LArkema/dctransistor-project/board_files/DCTransistor_standard_BOM.xlsx

Comment | Designator | Footprint | LCSC Part Number | Basic? | Doable |  | Old Part Numbers
MMBT3904 | Q1,Q0 | SOT-23 | C20526 | Y | Y |  | C20526
1N5819WS | D1,D0 | SOD-323 | C191023 | Y | Y |  | C191023
SN74LVC1T45DBV | U3 | SOT-23-6 | C7843 | Y | Y |  | C7843
CH340C | U0 | SOIC-16_3.9x9.9mm_P1.27mm | C84681 | N | N |  | C84681
ESP-12F | U2 | ESP-12E | C82891 | N | N |  | C82891
AMS1117-3.3 | U1 | SOT-223-3_TabPin2 | C6186 | Y | Y |  | C351784
SW_SPST | SW0 | SW_DIP_SPSTx01_Slide_6.7x4.1mm_W6.73mm_P2.54mm_LowProfile_JPin | C54948 | N | N |  | C54948
300 | R8 | R_0402_1005Metric | C25102 | Y | Y |  | C138010
12k | R4,R5 | R_0402_1005Metric | C25752 | Y | Y |  | C144798
470 | R1,R2 | R_0402_1005Metric | C25117 | Y | Y | 0402 | C114433
10k | R6,R7,R9 | R_0402_1005Metric | C25744 | Y | Y | 0402 | C17414
5.1kR | R3,R0 | R_0402_1005Metric | C25905 | Y | Y | 0402 | C14677
USB_C_Receptacle | J0 | USB_C_Receptacle_HRO_TYPE-C-31-M-12 | C165948 | N | N |  | C165948
Conn_02x01 | J1 | JST_PH_S2B-PH-SM4-TB_1x02-1MP_P2.00mm_Horizontal | C225233 | N | N |  | C225233
WS2812B | D70,D60,D30,D77,D101,D31,D79,D87,D20,D75,D36,D6,D38,D43,D26,D95,D46,D71,D98,D45,D68,D41,D76,D3,D100,D92,D64,D40,D27,D28,D10,D104,D63,D16,D74,D53,D61,D24,D37,D103,D5,D52,D29,D8,D99,D54,D25,D78,D39,D2,D102,D4,D57,D50,D44,D90,D97,D66,D58,D59,D83,D67,D82,D23,D15,D80,D51,D69,D32,D9,D62,D85,D48,D55,D91,D65,D73,D42,D13,D35,D72,D56,D22,D17,D33,D88,D49,D89,D34,D84,D21,D94,D14,D86,D47,D7,D81,D12,D93,D11,D96,D19,D18,D105,D106 | LED_WS2812B_PLCC4_5.0x5.0mm_P3.2mm-nosilk | C2843785 | N | N | To allow economic assembly | C2761795
100nf | C0,C2 | C_0603_1608Metric | C14663 | Y | Y | 0603 | C88219
10uF | C1,C3,C4,C5,C6,C7,C8,C9,C10,C11,C12,C13,C14,C15,C16,C17,C18,C19,C20,C21,C22,C23,C24,C25,C26,C27,C28,C29,C30,C31,C32,C33,C34,C35,C36,C37,C38,C39,C40,C41,C42 | C_0402_1005Metric | C15525 | Y | Y | 0402 | C466780
