LArkema/dctransistor-project/(threads)

Thread 1 (2022-03-06):

Narrow "Collision Check" for arriving trains

LArkema, 2022-03-06:
Currently, TrainLine's arrived() function  will not update a train's station state if another train is "at" (i.e. has not yet arrived at the next) that station. Designed to stop false-positive arrivals, particularly at 1st station (always waiting, same train may linger). However, a train may legitimately arrive at a station after the train in front has departed, but not yet arrived at next station, causing an incorrect state to propagate.

Fix by checking for specific circuitID of train in front of arriving train.

https://github.com/LArkema/WMATA_PCB/blob/c3f1eccd48eb8d6c2e151f4aa4d2035055f1f0ca/inc/TrainLine.h#L192

LArkema, 2023-04-08:
Closed a long time ago. Kind of forgot that I put this as a GitHub issue.

Closed 2023-04-08.

Thread 2 (2023-05-14):

Order 1090-5438 is missing an On-Off Switch

jasonliu125, 2023-05-14:
I hope you're doing well! My board appears to be missing an on off switch. I see the outline for where it's supposed to be but I cannot turn the board on. Would you be able to send a replacement or exchange this? Image attached.
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

LArkema, 2023-05-14:
Hello,

GitHub issues are meant for bugs and improvements with the software or project files. Individual board problems should be addressed via email to support@dctransistor.com or other DCTransistor email address to resolve individual issues. Please see email correspondence for this order.

Thank you for understanding, but this issue will be deleted in order to keep the repo focused on the open source project.

Closed 2023-05-14.

Thread 5 (2024-08-01):

Changelog?

pmwoodward3, 2024-08-01:
Really love this project! I have what I think is the OG board from the first run and it's still going strong.

I see that most of the releases just state that they are being pushed out from the automated pipeline, but I was wondering if there's any more information that we can get as far as what's being updated.

LArkema, 2024-08-01:
Ah, I had no idea anyone was actually watching the GitHub for update information. For the foreseeable future, the best bet is probably going to be looking at the commit history, as I try to summarize substantive changes when I push them (esp. for minor and major version updates).

PRs to the compile-sketches.yml file that make release notes more substantive (when it's not bumping a dependency or SSL fingerprint) are certainly welcome :)

Thread 6 (2025-06-26):

Not an issue, per se…

sean-bossinger, 2025-06-26:
Just curious for the folks following: has anyone thought through how to get the board to reflect the new service pattern on the Silver Line?

Might be cool to try that as a new fork.

I just didn’t want to go it my own way if someone else had thought about this.

LArkema, 2025-07-03:
Oh darn good catch. I'm swamped this summer and don't want to commit to any specific timelines, but I be able to set aside a day to work on this in September? Of course, if anyone else wants to fork and submit a PR, happy to accept that :)
