LArkema/dctransistor-project/board_files/DCTransistor_Bidirectional.kicad_sch

## KiCad design board_files/DCTransistor_Bidirectional.kicad_sch (2024-09-09)

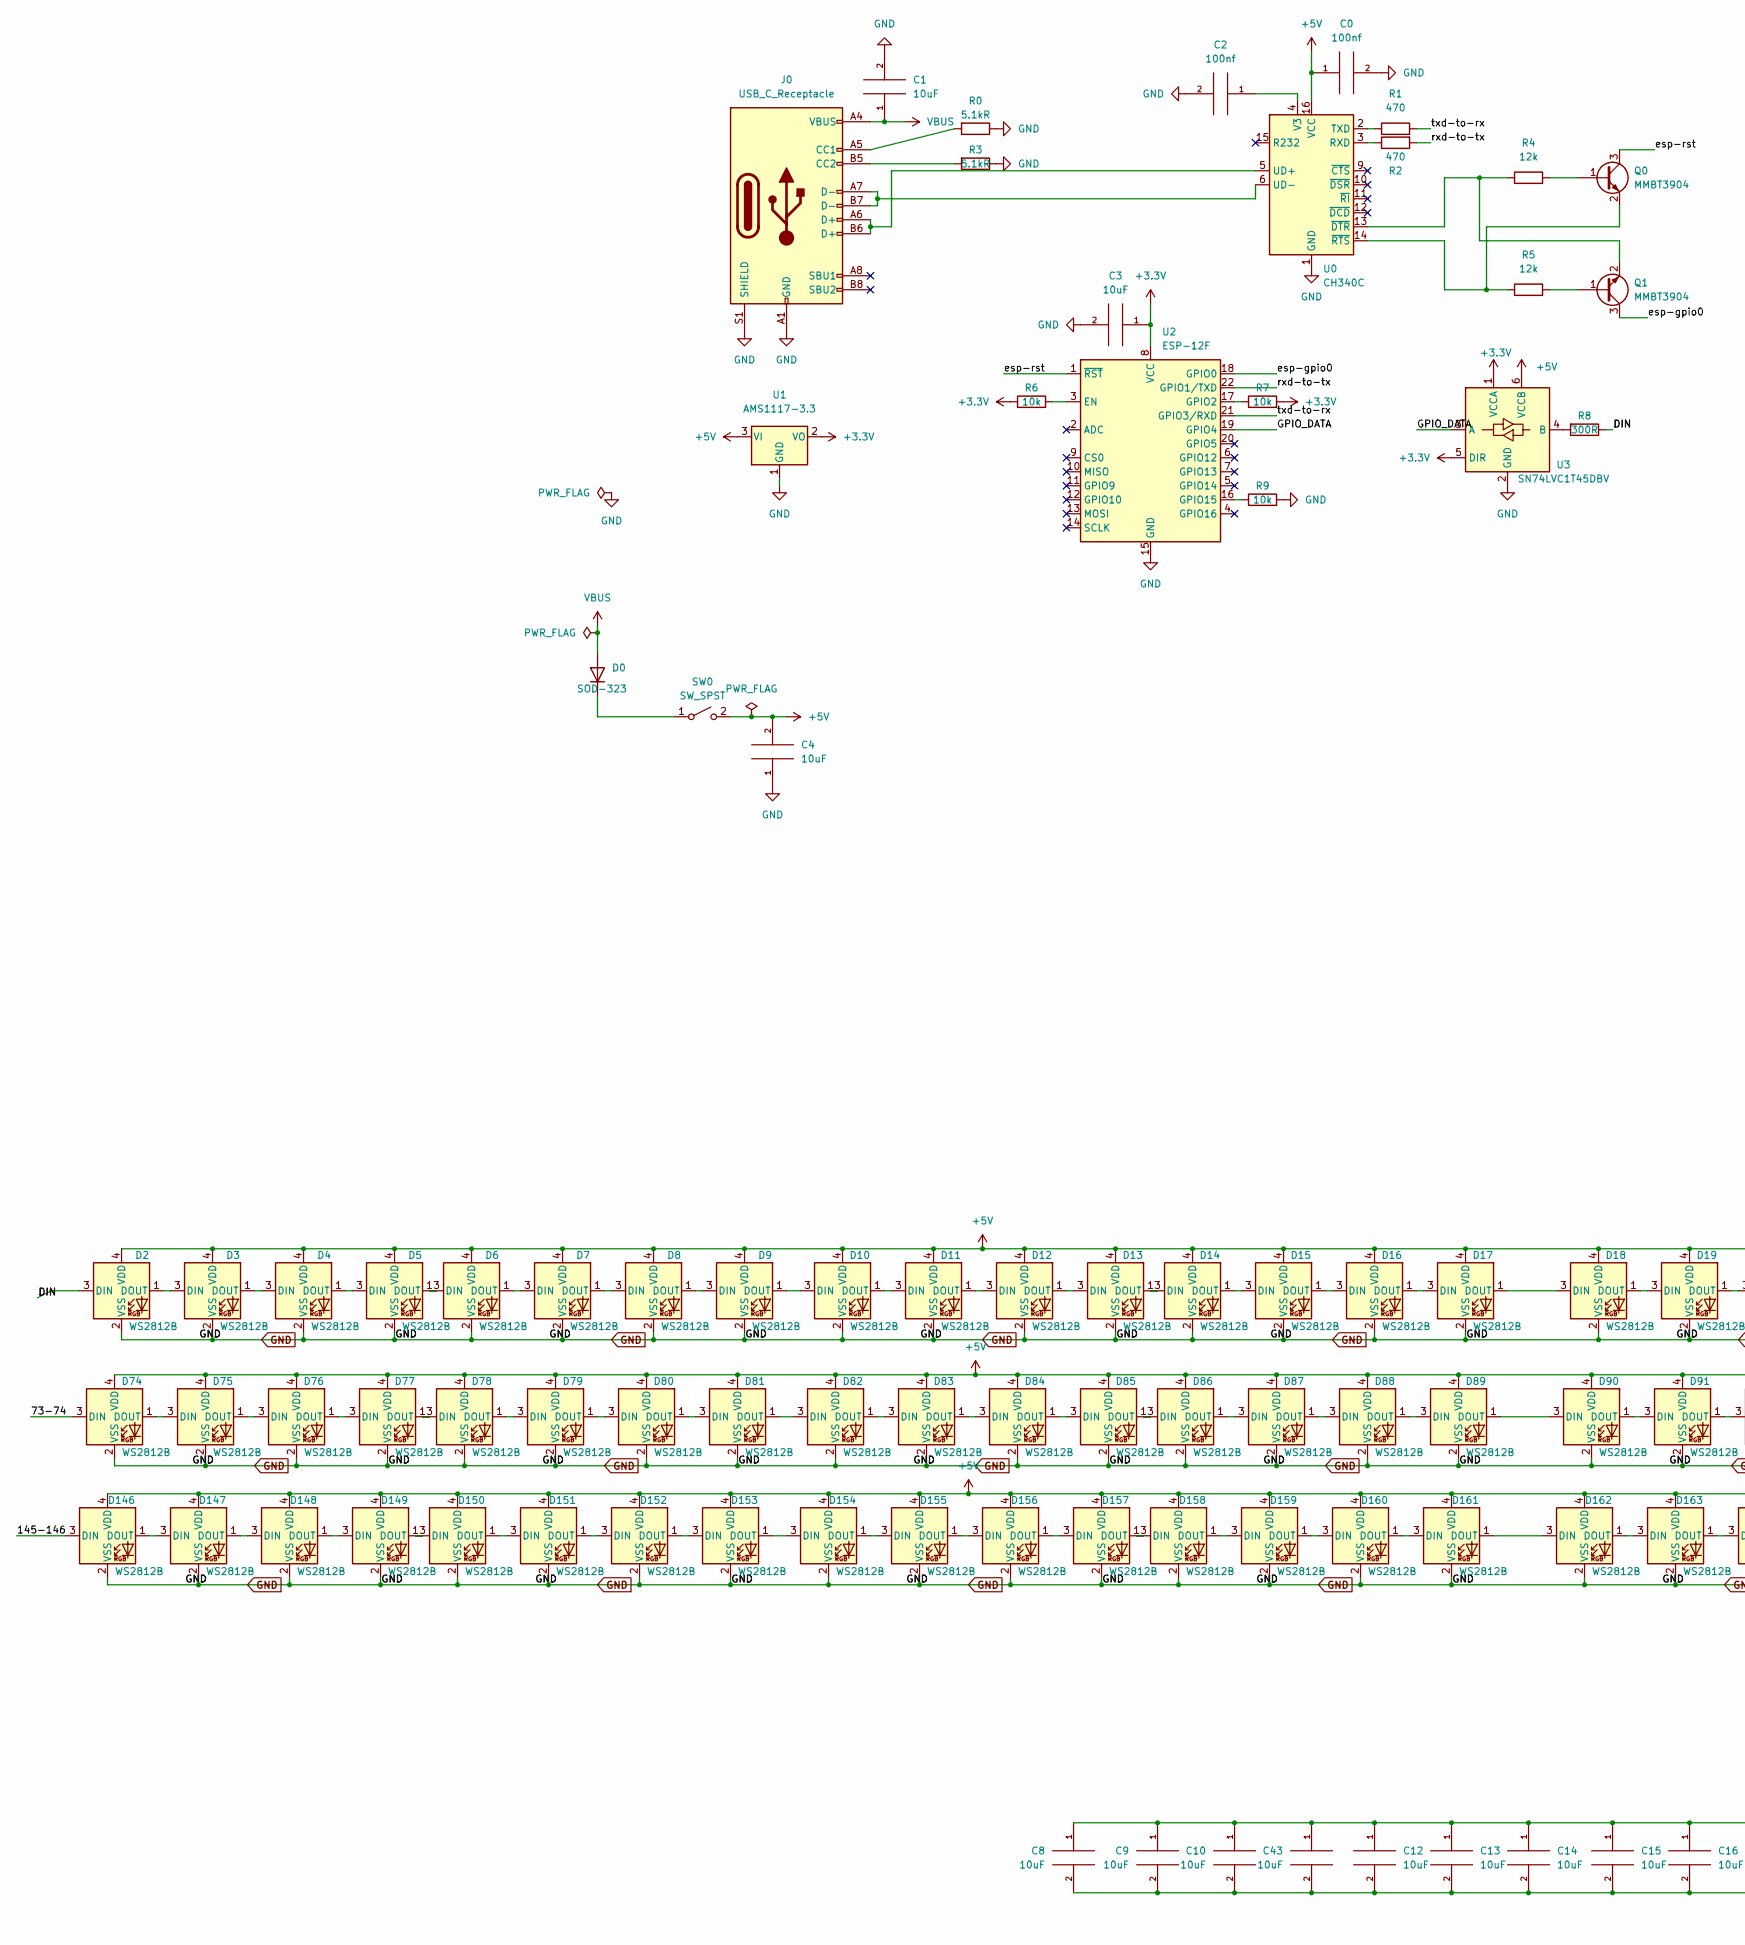
[picture p1: schematic DCTransistor_Bidirectional.kicad_sch, part in row 1, column 1]

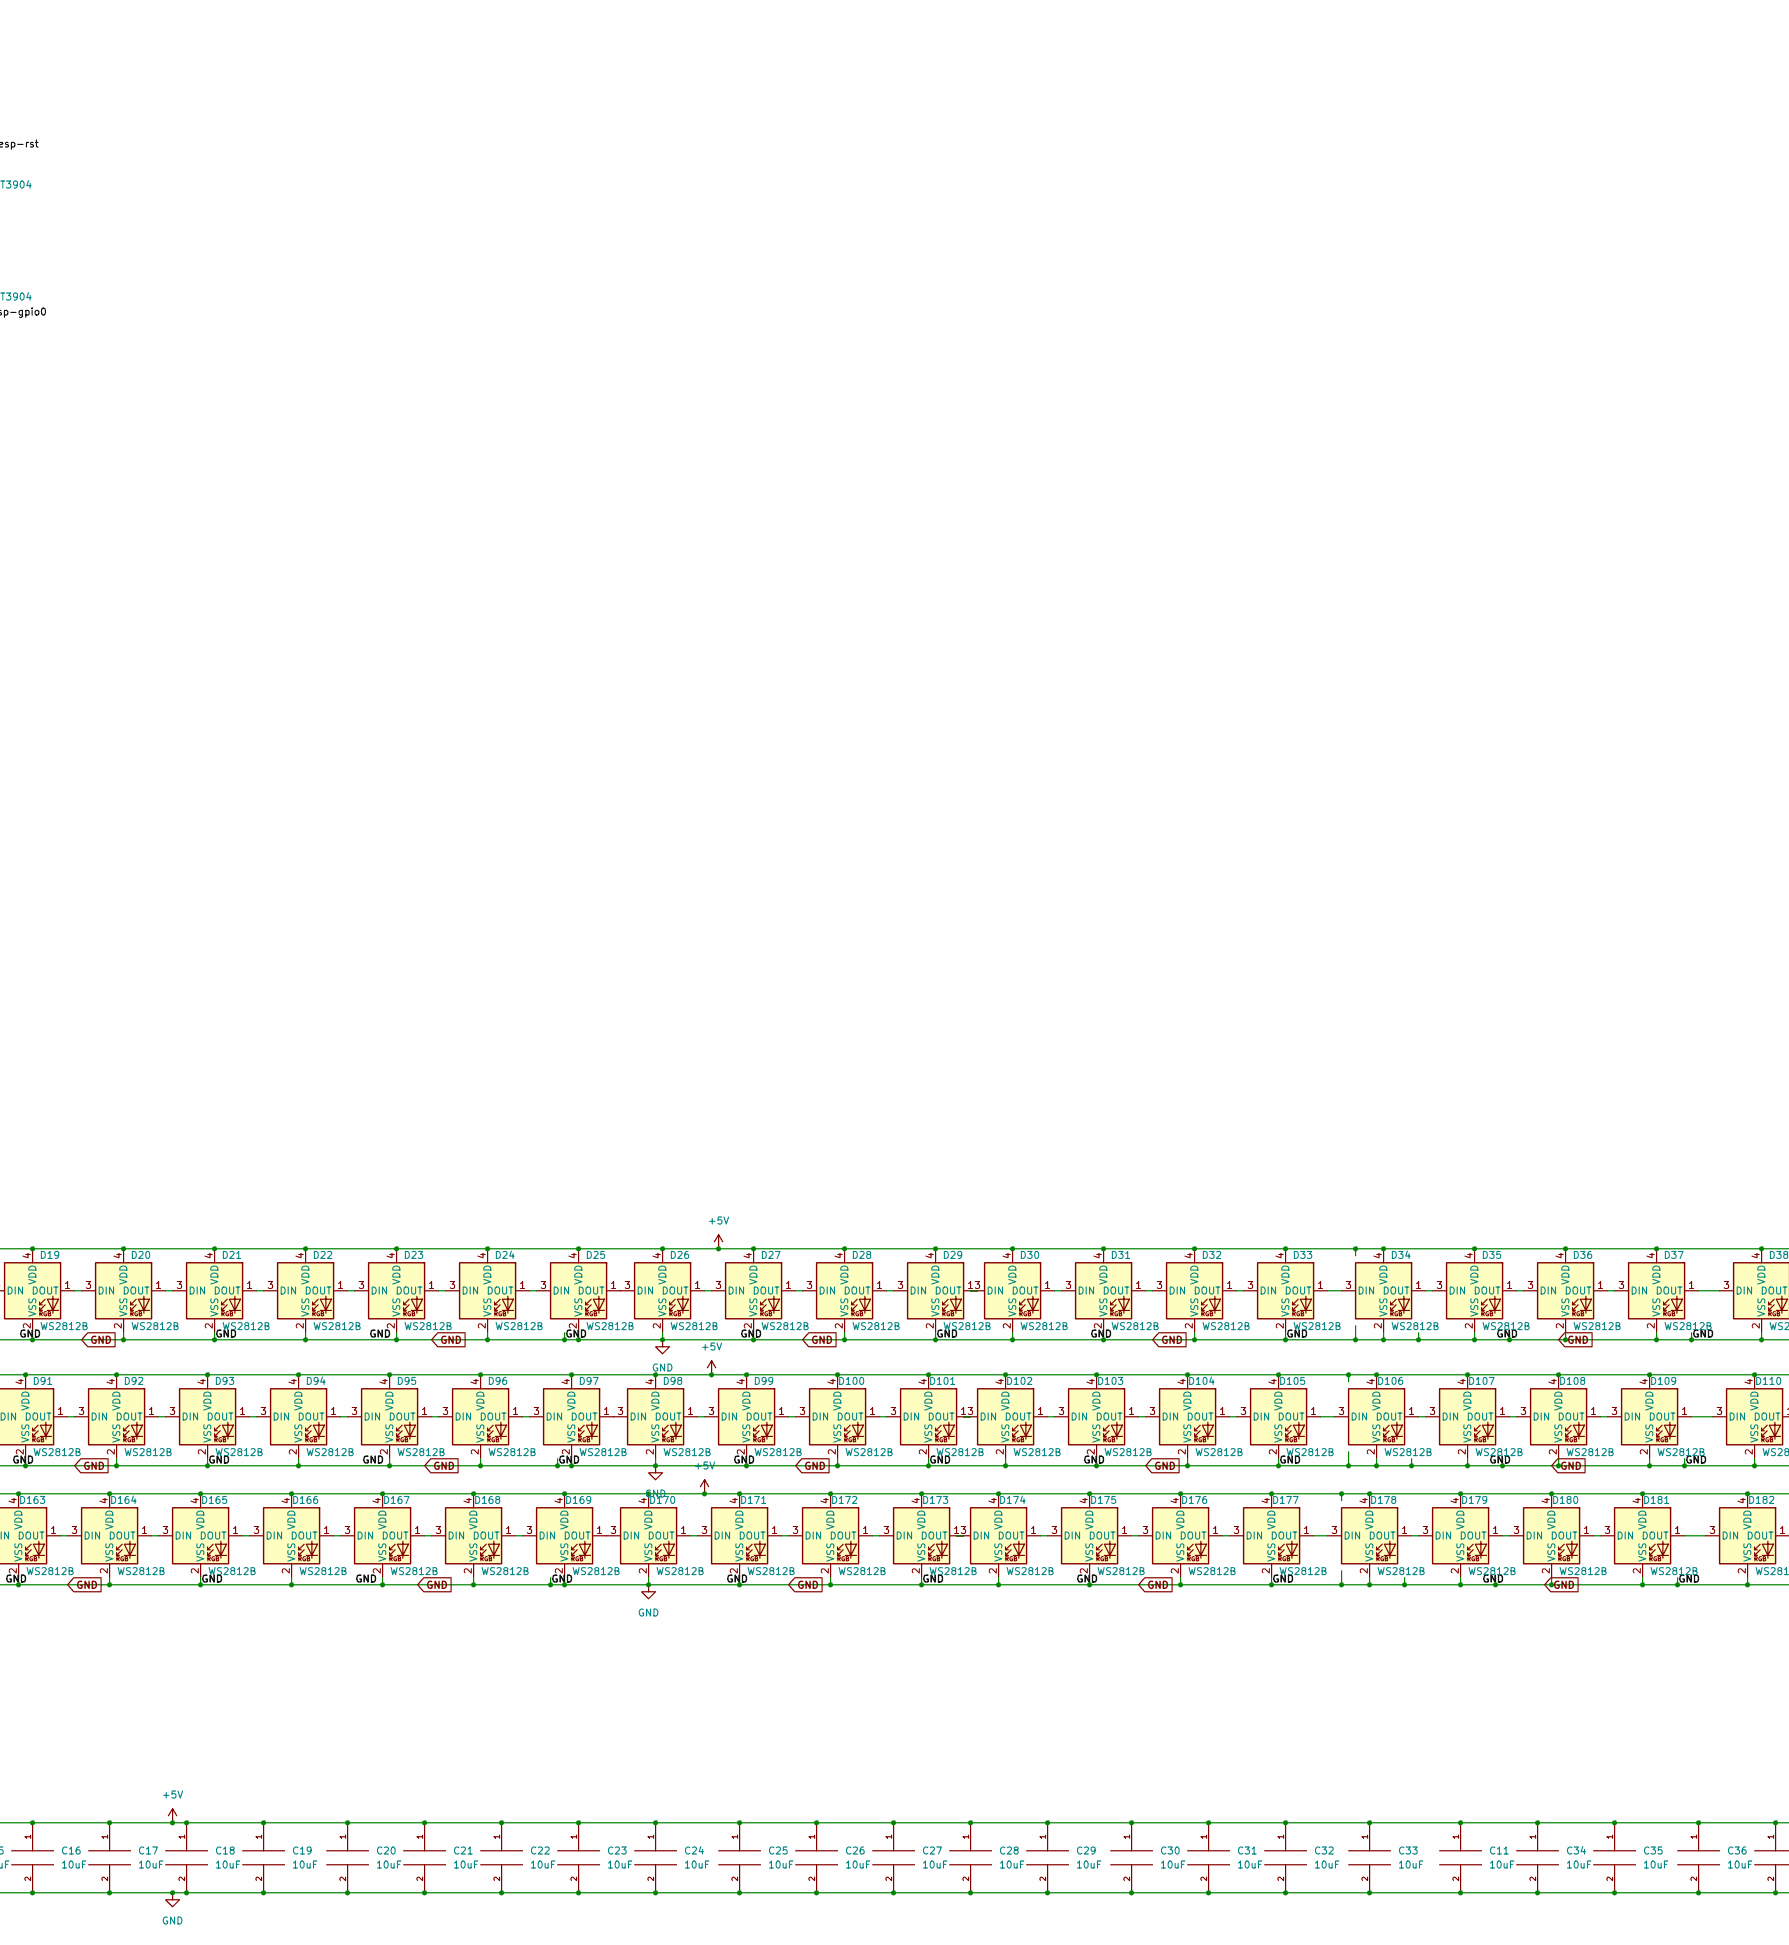
[picture p2: schematic DCTransistor_Bidirectional.kicad_sch, part in row 1, column 2]

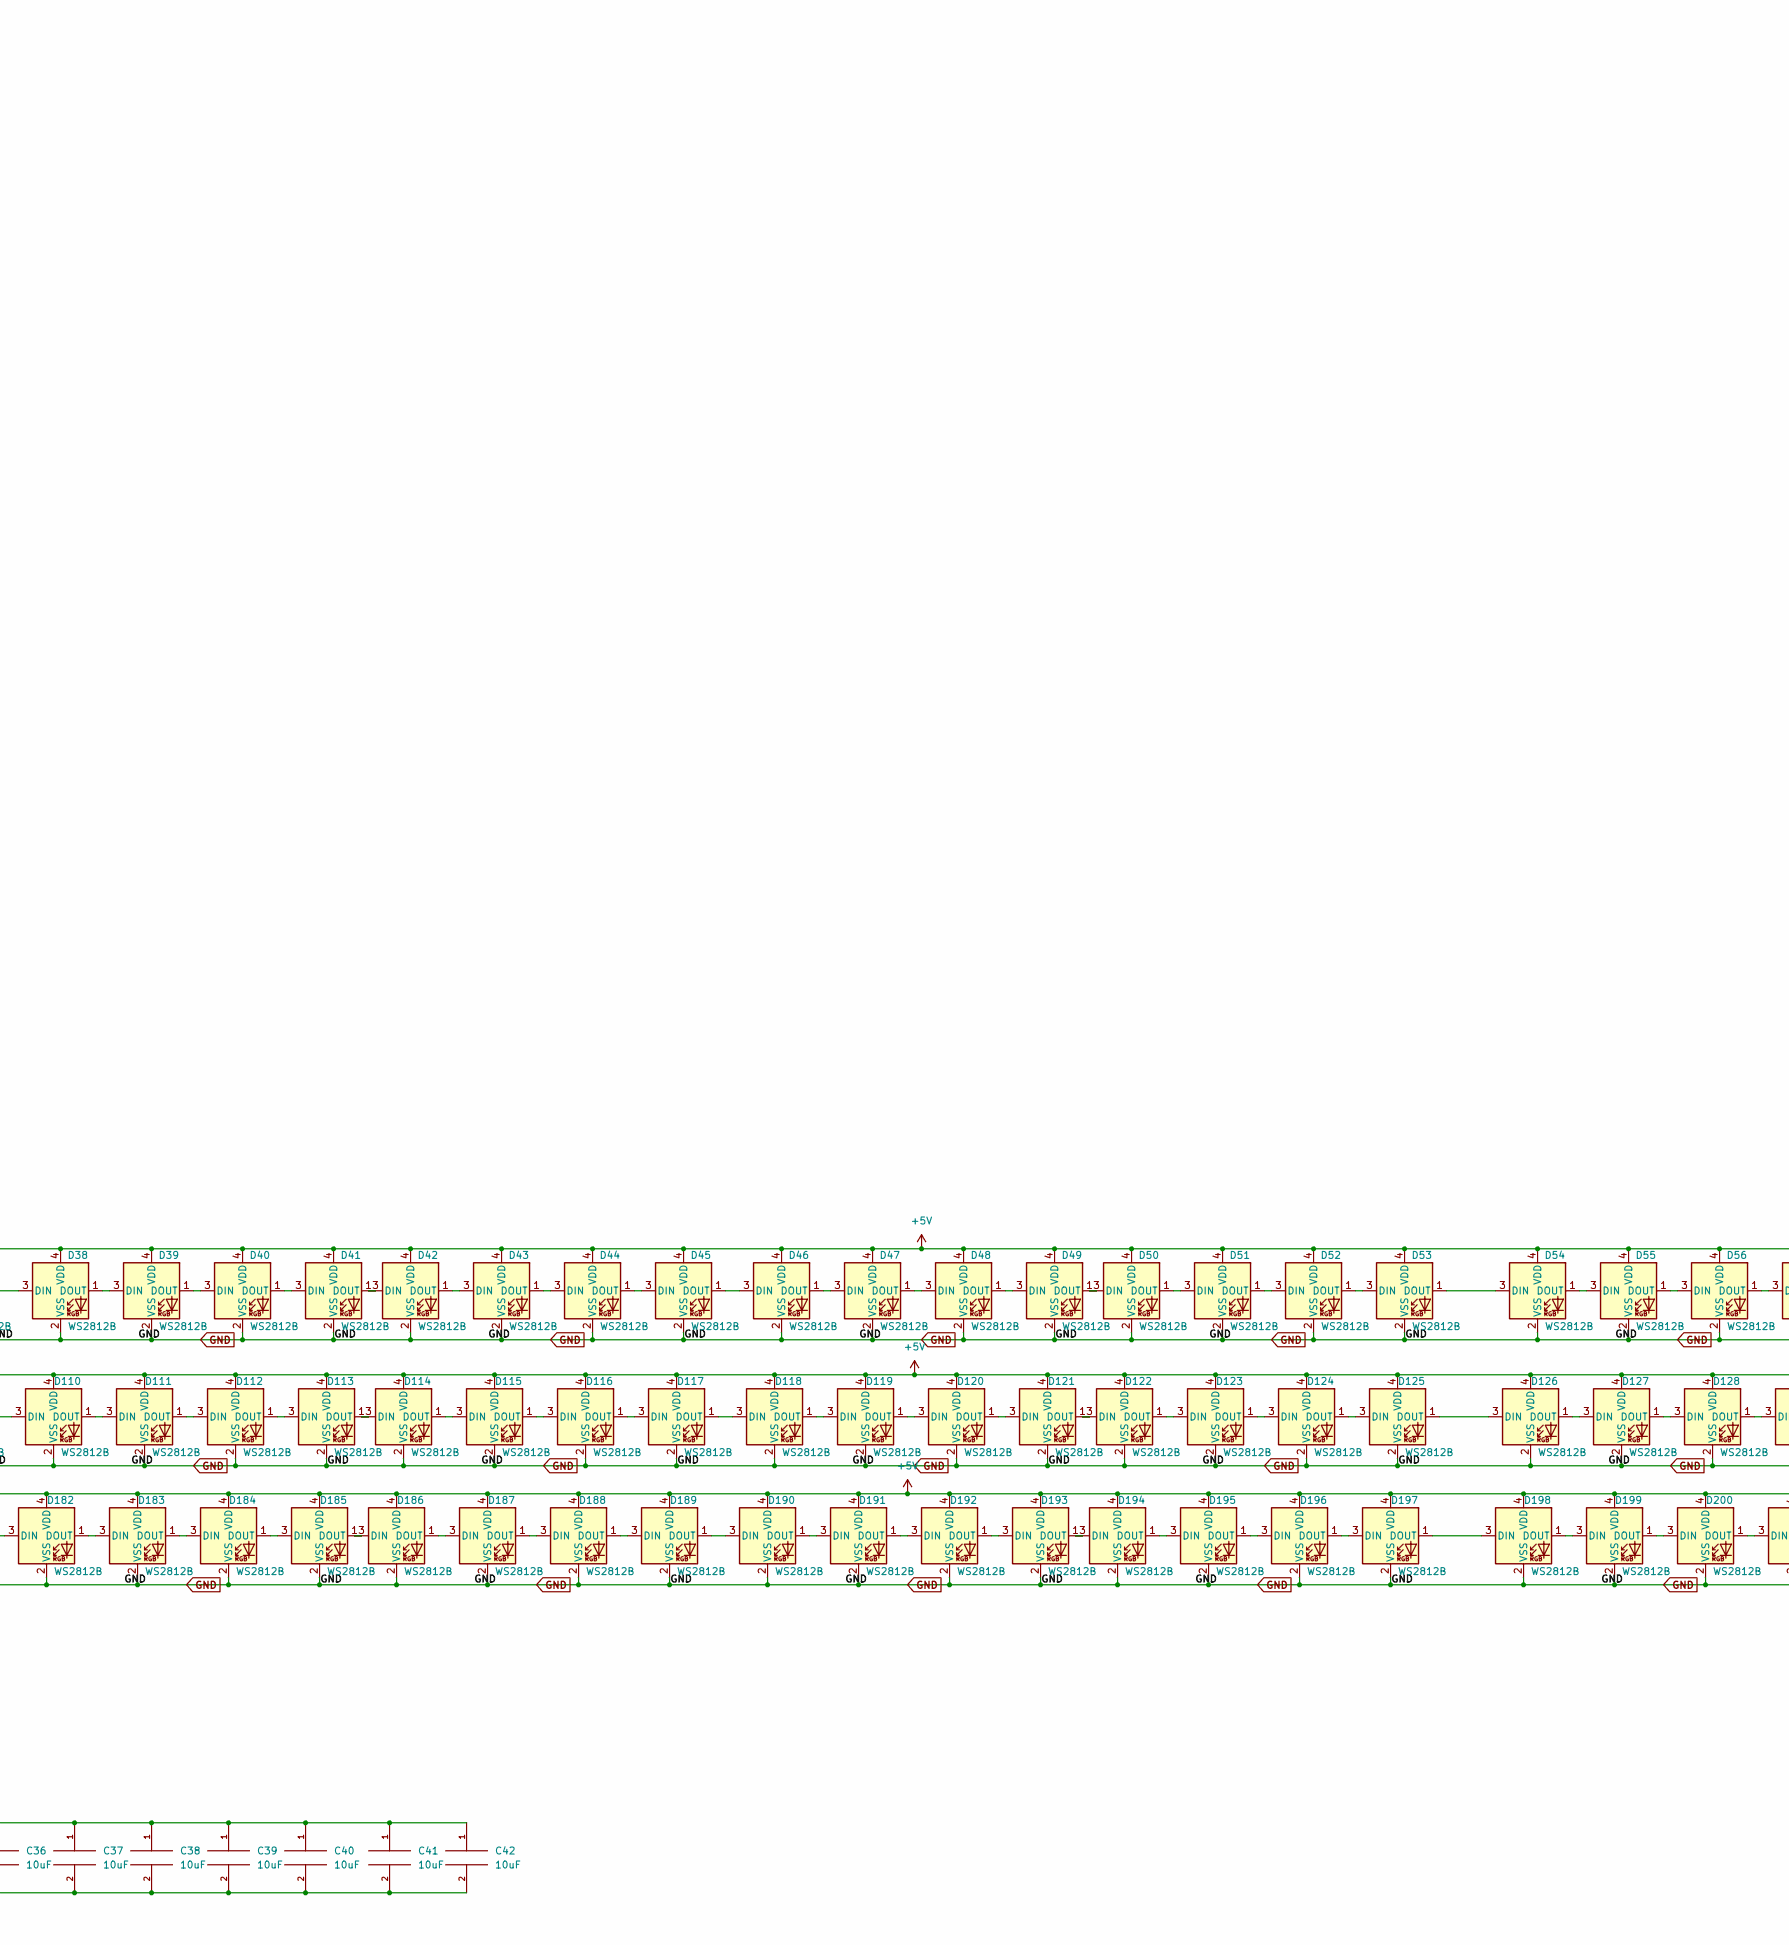
[picture p3: schematic DCTransistor_Bidirectional.kicad_sch, part in row 1, column 3]

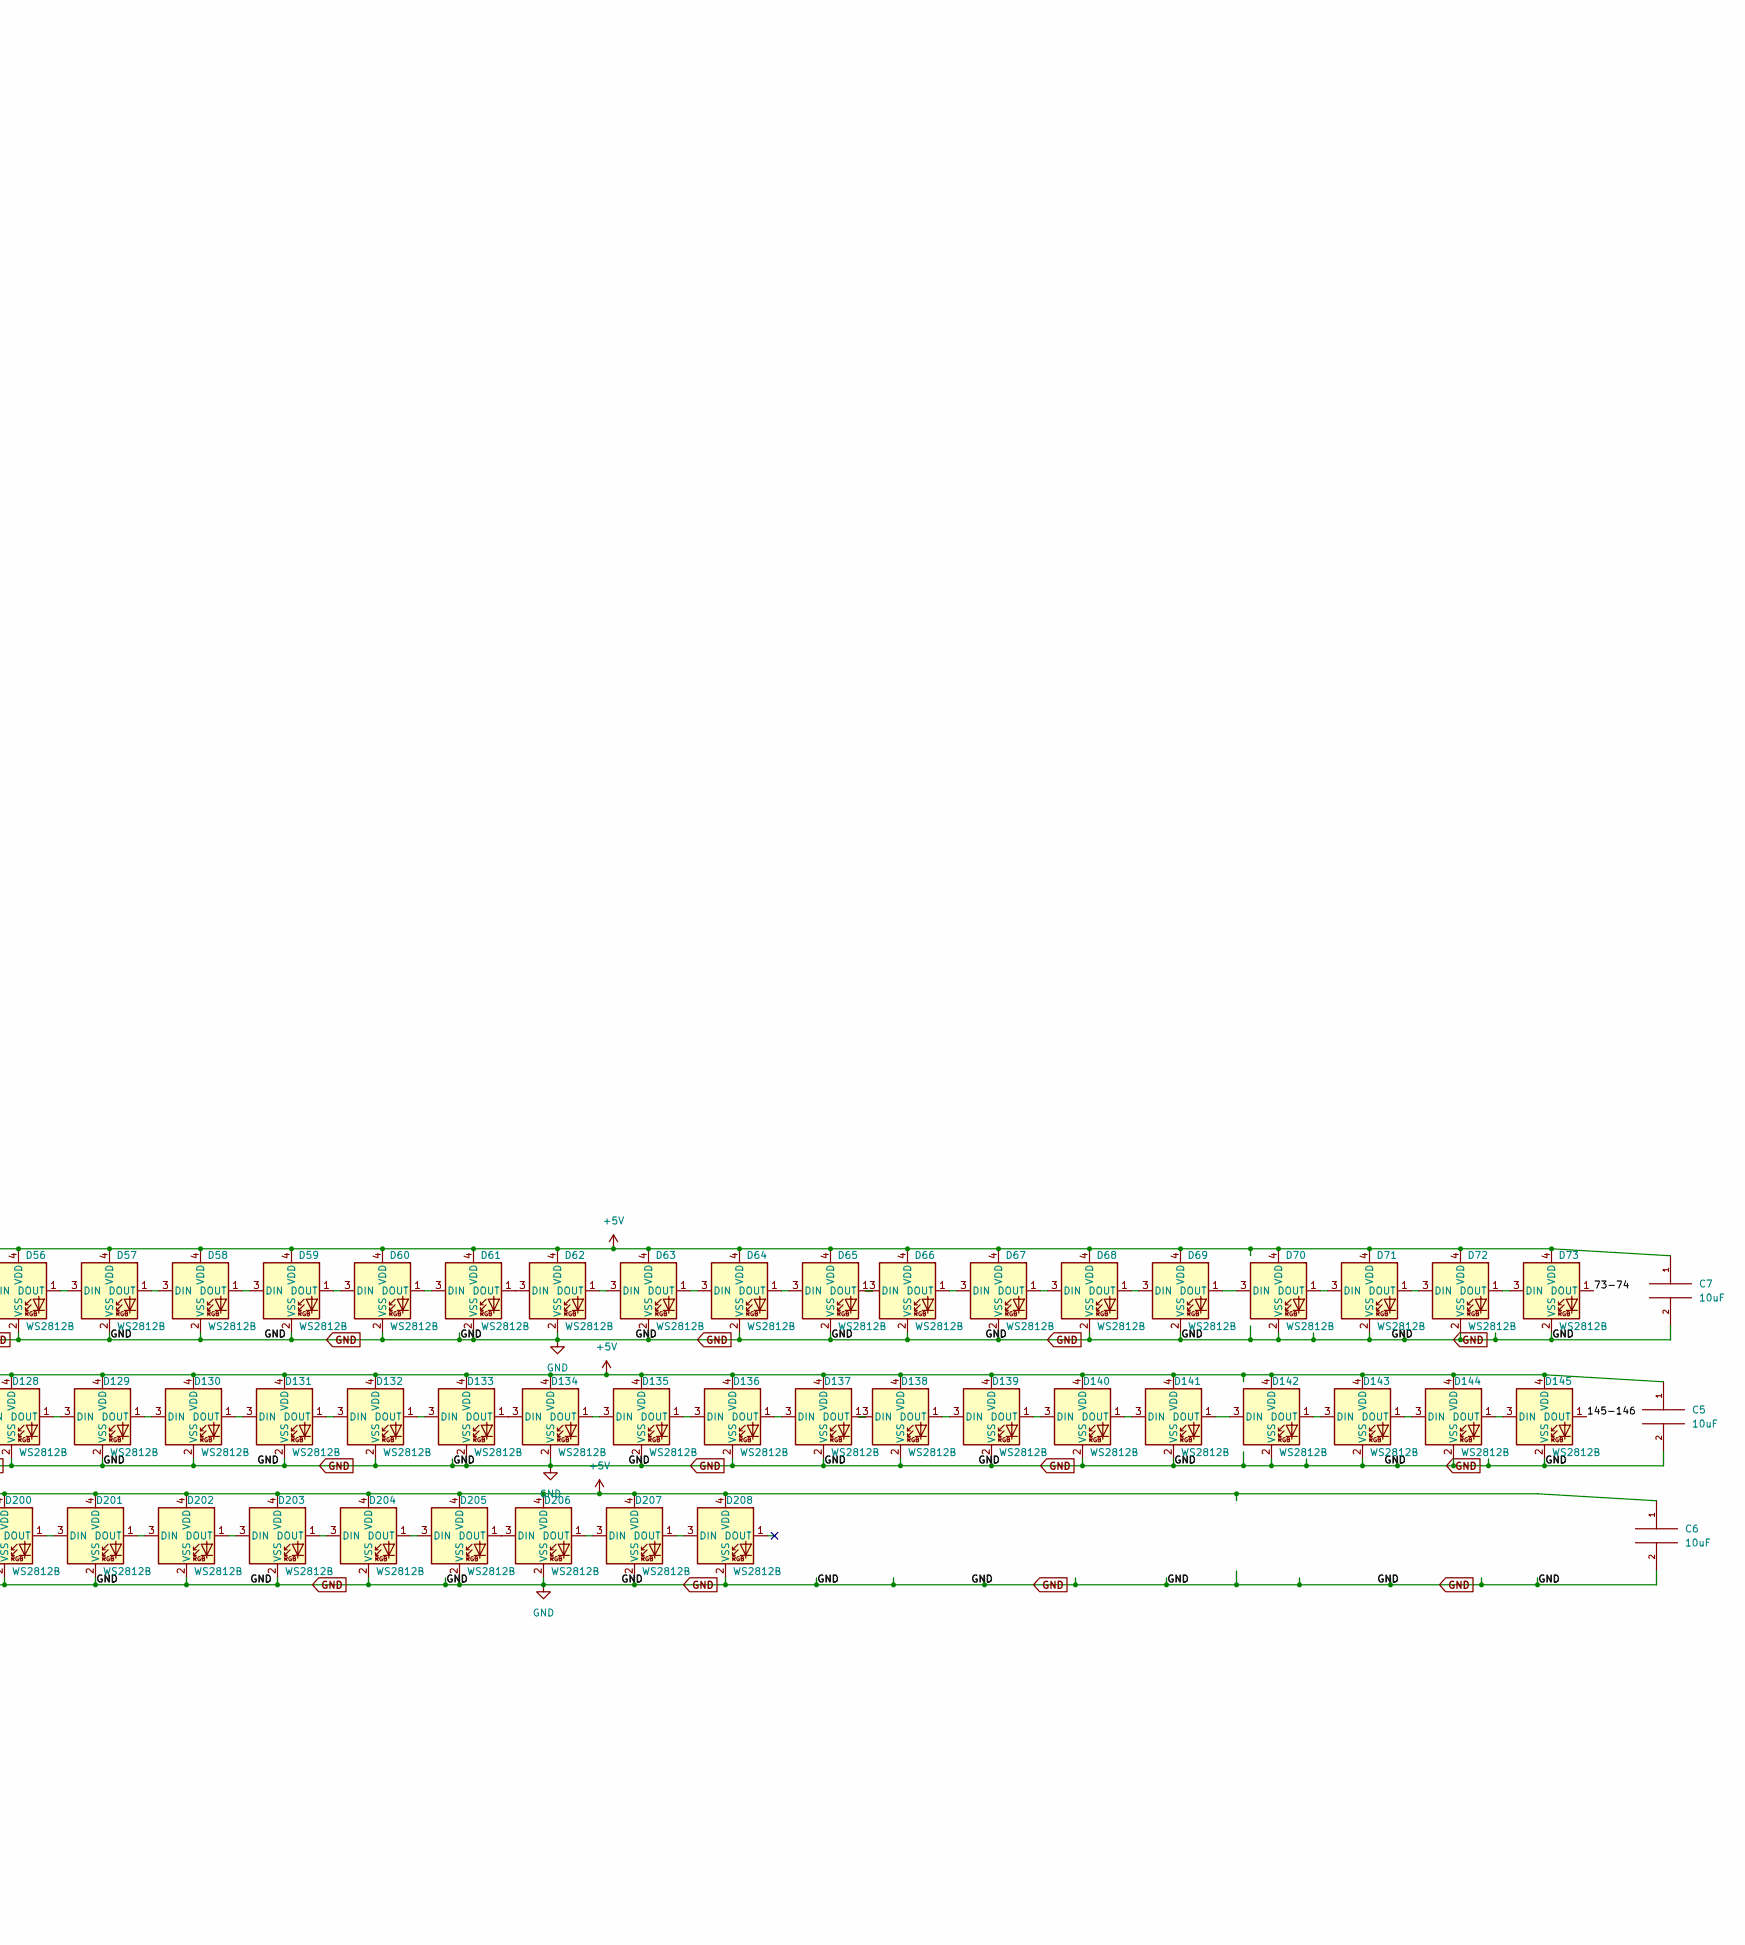
[picture p4: schematic DCTransistor_Bidirectional.kicad_sch, part in row 1, column 4]

Parts:
C0, C2: 100nf; C_0603_1608Metric
C1, C3, C4, C5, C6, C7, C8, C9, C10, C11, C12, C13, C14, C15, C16, C17, C18, C19, C20, C21, C22, C23, C24, C25, C26, C27, C28, C29, C30, C31, C32, C33, C34, C35, C36, C37, C38, C39, C40, C41, C42, C43: 10uF; C_0402_1005Metric
D0: SOD-323; D_SOD-323
D2, D3, D4, D5, D6, D7, D8, D9, D10, D11, D12, D13, D14, D15, D16, D17, D18, D19, D20, D21, D22, D23, D24, D25, D26, D27, D28, D29, D30, D31, D32, D33, D34, D35, D36, D37, D38, D39, D40, D41, D42, D43, D44, D45, D46, D47, D48, D49, D50, D51, D52, D53, D54, D55, D56, D57, D58, D59, D60, D61, D62, D63, D64, D65, D66, D67, D68, D69, D70, D71, D72, D73, D74, D75, D76, D77, D78, D79, D80, D81, D82, D83, D84, D85, D86, D87, D88, D89, D90, D91, D92, D93, D94, D95, D96, D97, D98, D99, D100, D101, D102, D103, D104, D105, D106, D107, D108, D109, D110, D111, D112, D113, D114, D115, D116, D117, D118, D119, D120, D121, D122, D123, D124, D125, D126, D127, D128, D129, D130, D131, D132, D133, D134, D135, D136, D137, D138, D139, D140, D141, D142, D143, D144, D145, D146, D147, D148, D149, D150, D151, D152, D153, D154, D155, D156, D157, D158, D159, D160, D161, D162, D163, D164, D165, D166, D167, D168, D169, D170, D171, D172, D173, D174, D175, D176, D177, D178, D179, D180, D181, D182, D183, D184, D185, D186, D187, D188, D189, D190, D191, D192, D193, D194, D195, D196, D197, D198, D199, D200, D201, D202, D203, D204, D205, D206, D207, D208: WS2812B; LED_WS2812B_2.0x2.0mm-nosilk
J0: USB_C_Receptacle; USB_C_Receptacle_HRO_TYPE-C-31-M-12
Q0, Q1: MMBT3904; SOT-23
R0, R3: 5.1kR; R_0402_1005Metric
R1, R2: 470; R_0402_1005Metric
R4, R5: 12k; R_0402_1005Metric
R6, R7, R9: 10k; R_0402_1005Metric
R8: 300R; R_0402_1005Metric
SW0: SW_SPST; SW_DIP_SPSTx01_Slide_6.7x4.1mm_W6.73mm_P2.54mm_LowProfile_J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
U0: CH340C; SOIC-16_3.9x9.9mm_P1.27mm
U1: AMS1117-3.3; SOT-223-3_TabPin2
U2: ESP-12F; ESP-12E
U3: SN74LVC1T45DBV; SOT-23-6

Connections:
73-74: D73.1 (DOUT), D74.3 (DIN)
145-146: D145.1 (DOUT), D146.3 (DIN)
+3.3V: C3.1, R6.1, R7.2, U1.2 (VO), U2.8 (VCC), U3.1 (VCCA), U3.5 (DIR)
+5V: C0.1, C4.2, C5.1, C6.1, C7.1, C8.1, C9.1, C10.1, C11.1, C12.1, C13.1, C14.1, C15.1, C16.1, C17.1, C18.1, C19.1, C20.1, C21.1, C22.1, C23.1, C24.1, C25.1, C26.1, C27.1, C28.1, C29.1, C30.1, C31.1, C32.1, C33.1, C34.1, C35.1, C36.1, C37.1, C38.1, C39.1, C40.1, C41.1, C42.1, C43.1, D2.4 (VDD), D3.4 (VDD), D4.4 (VDD), D5.4 (VDD), D6.4 (VDD), D7.4 (VDD), D8.4 (VDD), D9.4 (VDD), D10.4 (VDD), D11.4 (VDD), D12.4 (VDD), D13.4 (VDD), D14.4 (VDD), D15.4 (VDD), D16.4 (VDD), D17.4 (VDD), D18.4 (VDD), D19.4 (VDD), D20.4 (VDD), D21.4 (VDD), D22.4 (VDD), D23.4 (VDD), D24.4 (VDD), D25.4 (VDD), D26.4 (VDD), D27.4 (VDD), D28.4 (VDD), D29.4 (VDD), D30.4 (VDD), D31.4 (VDD), D32.4 (VDD), D33.4 (VDD), D34.4 (VDD), D35.4 (VDD), D36.4 (VDD), D37.4 (VDD), D38.4 (VDD), D39.4 (VDD), D40.4 (VDD), D41.4 (VDD), D42.4 (VDD), D43.4 (VDD), D44.4 (VDD), D45.4 (VDD), D46.4 (VDD), D47.4 (VDD), D48.4 (VDD), D49.4 (VDD), D50.4 (VDD), D51.4 (VDD), D52.4 (VDD), D53.4 (VDD), D54.4 (VDD), D55.4 (VDD), D56.4 (VDD), D57.4 (VDD), D58.4 (VDD), D59.4 (VDD), D60.4 (VDD), D61.4 (VDD), D62.4 (VDD), D63.4 (VDD), D64.4 (VDD), D65.4 (VDD), D66.4 (VDD), D67.4 (VDD), D68.4 (VDD), D69.4 (VDD), D70.4 (VDD), D71.4 (VDD), D72.4 (VDD), D73.4 (VDD), D74.4 (VDD), D75.4 (VDD), D76.4 (VDD), D77.4 (VDD), D78.4 (VDD), D79.4 (VDD), D80.4 (VDD), D81.4 (VDD), D82.4 (VDD), D83.4 (VDD), D84.4 (VDD), D85.4 (VDD), D86.4 (VDD), D87.4 (VDD), D88.4 (VDD), D89.4 (VDD), D90.4 (VDD), D91.4 (VDD), D92.4 (VDD), D93.4 (VDD), D94.4 (VDD), D95.4 (VDD), D96.4 (VDD), D97.4 (VDD), D98.4 (VDD), D99.4 (VDD), D100.4 (VDD), D101.4 (VDD), D102.4 (VDD), D103.4 (VDD), D104.4 (VDD), D105.4 (VDD), D106.4 (VDD), D107.4 (VDD), D108.4 (VDD), D109.4 (VDD), D110.4 (VDD), D111.4 (VDD), D112.4 (VDD), D113.4 (VDD), D114.4 (VDD), D115.4 (VDD), D116.4 (VDD), D117.4 (VDD), D118.4 (VDD), D119.4 (VDD), D120.4 (VDD), D121.4 (VDD), D122.4 (VDD), D123.4 (VDD), D124.4 (VDD), D125.4 (VDD), D126.4 (VDD), D127.4 (VDD), D128.4 (VDD), D129.4 (VDD), D130.4 (VDD), D131.4 (VDD), D132.4 (VDD), D133.4 (VDD), D134.4 (VDD), D135.4 (VDD), D136.4 (VDD), D137.4 (VDD), D138.4 (VDD), D139.4 (VDD), D140.4 (VDD), D141.4 (VDD), D142.4 (VDD), D143.4 (VDD), D144.4 (VDD), D145.4 (VDD), D146.4 (VDD), D147.4 (VDD), D148.4 (VDD), D149.4 (VDD), D150.4 (VDD), D151.4 (VDD), D152.4 (VDD), D153.4 (VDD), D154.4 (VDD), D155.4 (VDD), D156.4 (VDD), D157.4 (VDD), D158.4 (VDD), D159.4 (VDD), D160.4 (VDD), D161.4 (VDD), D162.4 (VDD), D163.4 (VDD), D164.4 (VDD), D165.4 (VDD), D166.4 (VDD), D167.4 (VDD), D168.4 (VDD), D169.4 (VDD), D170.4 (VDD), D171.4 (VDD), D172.4 (VDD), D173.4 (VDD), D174.4 (VDD), D175.4 (VDD), D176.4 (VDD), D177.4 (VDD), D178.4 (VDD), D179.4 (VDD), D180.4 (VDD), D181.4 (VDD), D182.4 (VDD), D183.4 (VDD), D184.4 (VDD), D185.4 (VDD), D186.4 (VDD), D187.4 (VDD), D188.4 (VDD), D189.4 (VDD), D190.4 (VDD), D191.4 (VDD), D192.4 (VDD), D193.4 (VDD), D194.4 (VDD), D195.4 (VDD), D196.4 (VDD), D197.4 (VDD), D198.4 (VDD), D199.4 (VDD), D200.4 (VDD), D201.4 (VDD), D202.4 (VDD), D203.4 (VDD), D204.4 (VDD), D205.4 (VDD), D206.4 (VDD), D207.4 (VDD), D208.4 (VDD), SW0.2 (B), U0.16 (VCC), U1.3 (VI), U3.6 (VCCB)
DIN: D2.3 (DIN), R8.1
GND: C0.2, C1.2, C2.2, C3.2, C4.1, C5.2, C6.2, C7.2, C8.2, C9.2, C10.2, C11.2, C12.2, C13.2, C14.2, C15.2, C16.2, C17.2, C18.2, C19.2, C20.2, C21.2, C22.2, C23.2, C24.2, C25.2, C26.2, C27.2, C28.2, C29.2, C30.2, C31.2, C32.2, C33.2, C34.2, C35.2, C36.2, C37.2, C38.2, C39.2, C40.2, C41.2, C42.2, C43.2, D2.2 (VSS), D3.2 (VSS), D4.2 (VSS), D5.2 (VSS), D6.2 (VSS), D7.2 (VSS), D8.2 (VSS), D9.2 (VSS), D10.2 (VSS), D11.2 (VSS), D12.2 (VSS), D13.2 (VSS), D14.2 (VSS), D15.2 (VSS), D16.2 (VSS), D17.2 (VSS), D18.2 (VSS), D19.2 (VSS), D20.2 (VSS), D21.2 (VSS), D22.2 (VSS), D23.2 (VSS), D24.2 (VSS), D25.2 (VSS), D26.2 (VSS), D27.2 (VSS), D28.2 (VSS), D29.2 (VSS), D30.2 (VSS), D31.2 (VSS), D32.2 (VSS), D33.2 (VSS), D34.2 (VSS), D35.2 (VSS), D36.2 (VSS), D37.2 (VSS), D38.2 (VSS), D39.2 (VSS), D40.2 (VSS), D41.2 (VSS), D42.2 (VSS), D43.2 (VSS), D44.2 (VSS), D45.2 (VSS), D46.2 (VSS), D47.2 (VSS), D48.2 (VSS), D49.2 (VSS), D50.2 (VSS), D51.2 (VSS), D52.2 (VSS), D53.2 (VSS), D54.2 (VSS), D55.2 (VSS), D56.2 (VSS), D57.2 (VSS), D58.2 (VSS), D59.2 (VSS), D60.2 (VSS), D61.2 (VSS), D62.2 (VSS), D63.2 (VSS), D64.2 (VSS), D65.2 (VSS), D66.2 (VSS), D67.2 (VSS), D68.2 (VSS), D69.2 (VSS), D70.2 (VSS), D71.2 (VSS), D72.2 (VSS), D73.2 (VSS), D74.2 (VSS), D75.2 (VSS), D76.2 (VSS), D77.2 (VSS), D78.2 (VSS), D79.2 (VSS), D80.2 (VSS), D81.2 (VSS), D82.2 (VSS), D83.2 (VSS), D84.2 (VSS), D85.2 (VSS), D86.2 (VSS), D87.2 (VSS), D88.2 (VSS), D89.2 (VSS), D90.2 (VSS), D91.2 (VSS), D92.2 (VSS), D93.2 (VSS), D94.2 (VSS), D95.2 (VSS), D96.2 (VSS), D97.2 (VSS), D98.2 (VSS), D99.2 (VSS), D100.2 (VSS), D101.2 (VSS), D102.2 (VSS), D103.2 (VSS), D104.2 (VSS), D105.2 (VSS), D106.2 (VSS), D107.2 (VSS), D108.2 (VSS), D109.2 (VSS), D110.2 (VSS), D111.2 (VSS), D112.2 (VSS), D113.2 (VSS), D114.2 (VSS), D115.2 (VSS), D116.2 (VSS), D117.2 (VSS), D118.2 (VSS), D119.2 (VSS), D120.2 (VSS), D121.2 (VSS), D122.2 (VSS), D123.2 (VSS), D124.2 (VSS), D125.2 (VSS), D126.2 (VSS), D127.2 (VSS), D128.2 (VSS), D129.2 (VSS), D130.2 (VSS), D131.2 (VSS), D132.2 (VSS), D133.2 (VSS), D134.2 (VSS), D135.2 (VSS), D136.2 (VSS), D137.2 (VSS), D138.2 (VSS), D139.2 (VSS), D140.2 (VSS), D141.2 (VSS), D142.2 (VSS), D143.2 (VSS), D144.2 (VSS), D145.2 (VSS), D146.2 (VSS), D147.2 (VSS), D148.2 (VSS), D149.2 (VSS), D150.2 (VSS), D151.2 (VSS), D152.2 (VSS), D153.2 (VSS), D154.2 (VSS), D155.2 (VSS), D156.2 (VSS), D157.2 (VSS), D158.2 (VSS), D159.2 (VSS), D160.2 (VSS), D161.2 (VSS), D162.2 (VSS), D163.2 (VSS), D164.2 (VSS), D165.2 (VSS), D166.2 (VSS), D167.2 (VSS), D168.2 (VSS), D169.2 (VSS), D170.2 (VSS), D171.2 (VSS), D172.2 (VSS), D173.2 (VSS), D174.2 (VSS), D175.2 (VSS), D176.2 (VSS), D177.2 (VSS), D178.2 (VSS), D179.2 (VSS), D180.2 (VSS), D181.2 (VSS), D182.2 (VSS), D183.2 (VSS), D184.2 (VSS), D185.2 (VSS), D186.2 (VSS), D187.2 (VSS), D188.2 (VSS), D189.2 (VSS), D190.2 (VSS), D191.2 (VSS), D192.2 (VSS), D193.2 (VSS), D194.2 (VSS), D195.2 (VSS), D196.2 (VSS), D197.2 (VSS), D198.2 (VSS), D199.2 (VSS), D200.2 (VSS), D201.2 (VSS), D202.2 (VSS), D203.2 (VSS), D204.2 (VSS), D205.2 (VSS), D206.2 (VSS), D207.2 (VSS), D208.2 (VSS), J0.A1 (GND), J0.A12 (GND), J0.B1 (GND), J0.B12 (GND), J0.S1 (SHIELD), R0.1, R3.1, R9.2, U0.1 (GND), U1.1 (GND), U2.15 (GND), U3.2 (GND)
GPIO_DATA: U2.19 (GPIO4), U3.3 (A)
unnamed: C2.1, U0.4 (V3)
unnamed: D0.1 (K), SW0.1 (A)
unnamed: D2.1 (DOUT), D3.3 (DIN)
unnamed: D3.1 (DOUT), D4.3 (DIN)
unnamed: D4.1 (DOUT), D5.3 (DIN)
unnamed: D5.1 (DOUT), D6.3 (DIN)
unnamed: D6.1 (DOUT), D7.3 (DIN)
unnamed: D7.1 (DOUT), D8.3 (DIN)
unnamed: D8.1 (DOUT), D9.3 (DIN)
unnamed: D10.1 (DOUT), D11.3 (DIN)
unnamed: D9.1 (DOUT), D10.3 (DIN)
unnamed: D11.1 (DOUT), D12.3 (DIN)
unnamed: D12.1 (DOUT), D13.3 (DIN)
unnamed: D13.1 (DOUT), D14.3 (DIN)
unnamed: D14.1 (DOUT), D15.3 (DIN)
unnamed: D15.1 (DOUT), D16.3 (DIN)
unnamed: D16.1 (DOUT), D17.3 (DIN)
unnamed: D17.1 (DOUT), D18.3 (DIN)
unnamed: D18.1 (DOUT), D19.3 (DIN)
unnamed: D19.1 (DOUT), D20.3 (DIN)
unnamed: D20.1 (DOUT), D21.3 (DIN)
unnamed: D21.1 (DOUT), D22.3 (DIN)
unnamed: D22.1 (DOUT), D23.3 (DIN)
unnamed: D23.1 (DOUT), D24.3 (DIN)
unnamed: D24.1 (DOUT), D25.3 (DIN)
unnamed: D25.1 (DOUT), D26.3 (DIN)
unnamed: D26.1 (DOUT), D27.3 (DIN)
unnamed: D27.1 (DOUT), D28.3 (DIN)
unnamed: D28.1 (DOUT), D29.3 (DIN)
unnamed: D29.1 (DOUT), D30.3 (DIN)
unnamed: D30.1 (DOUT), D31.3 (DIN)
unnamed: D31.1 (DOUT), D32.3 (DIN)
unnamed: D32.1 (DOUT), D33.3 (DIN)
unnamed: D33.1 (DOUT), D34.3 (DIN)
unnamed: D34.1 (DOUT), D35.3 (DIN)
unnamed: D35.1 (DOUT), D36.3 (DIN)
unnamed: D36.1 (DOUT), D37.3 (DIN)
unnamed: D37.1 (DOUT), D38.3 (DIN)
unnamed: D38.1 (DOUT), D39.3 (DIN)
unnamed: D39.1 (DOUT), D40.3 (DIN)
unnamed: D40.1 (DOUT), D41.3 (DIN)
unnamed: D41.1 (DOUT), D42.3 (DIN)
unnamed: D42.1 (DOUT), D43.3 (DIN)
unnamed: D43.1 (DOUT), D44.3 (DIN)
unnamed: D44.1 (DOUT), D45.3 (DIN)
unnamed: D45.1 (DOUT), D46.3 (DIN)
unnamed: D46.1 (DOUT), D47.3 (DIN)
unnamed: D47.1 (DOUT), D48.3 (DIN)
unnamed: D48.1 (DOUT), D49.3 (DIN)
unnamed: D49.1 (DOUT), D50.3 (DIN)
unnamed: D50.1 (DOUT), D51.3 (DIN)
unnamed: D51.1 (DOUT), D52.3 (DIN)
unnamed: D52.1 (DOUT), D53.3 (DIN)
unnamed: D53.1 (DOUT), D54.3 (DIN)
unnamed: D54.1 (DOUT), D55.3 (DIN)
unnamed: D55.1 (DOUT), D56.3 (DIN)
unnamed: D56.1 (DOUT), D57.3 (DIN)
unnamed: D57.1 (DOUT), D58.3 (DIN)
unnamed: D58.1 (DOUT), D59.3 (DIN)
unnamed: D59.1 (DOUT), D60.3 (DIN)
unnamed: D60.1 (DOUT), D61.3 (DIN)
unnamed: D61.1 (DOUT), D62.3 (DIN)
unnamed: D62.1 (DOUT), D63.3 (DIN)
unnamed: D63.1 (DOUT), D64.3 (DIN)
unnamed: D64.1 (DOUT), D65.3 (DIN)
unnamed: D65.1 (DOUT), D66.3 (DIN)
unnamed: D66.1 (DOUT), D67.3 (DIN)
unnamed: D67.1 (DOUT), D68.3 (DIN)
unnamed: D68.1 (DOUT), D69.3 (DIN)
unnamed: D69.1 (DOUT), D70.3 (DIN)
unnamed: D70.1 (DOUT), D71.3 (DIN)
unnamed: D71.1 (DOUT), D72.3 (DIN)
unnamed: D72.1 (DOUT), D73.3 (DIN)
unnamed: D74.1 (DOUT), D75.3 (DIN)
unnamed: D75.1 (DOUT), D76.3 (DIN)
unnamed: D76.1 (DOUT), D77.3 (DIN)
unnamed: D77.1 (DOUT), D78.3 (DIN)
unnamed: D78.1 (DOUT), D79.3 (DIN)
unnamed: D79.1 (DOUT), D80.3 (DIN)
unnamed: D80.1 (DOUT), D81.3 (DIN)
unnamed: D81.1 (DOUT), D82.3 (DIN)
unnamed: D82.1 (DOUT), D83.3 (DIN)
unnamed: D83.1 (DOUT), D84.3 (DIN)
unnamed: D84.1 (DOUT), D85.3 (DIN)
unnamed: D85.1 (DOUT), D86.3 (DIN)
unnamed: D86.1 (DOUT), D87.3 (DIN)
unnamed: D87.1 (DOUT), D88.3 (DIN)
unnamed: D88.1 (DOUT), D89.3 (DIN)
unnamed: D89.1 (DOUT), D90.3 (DIN)
unnamed: D90.1 (DOUT), D91.3 (DIN)
unnamed: D91.1 (DOUT), D92.3 (DIN)
unnamed: D92.1 (DOUT), D93.3 (DIN)
unnamed: D93.1 (DOUT), D94.3 (DIN)
unnamed: D94.1 (DOUT), D95.3 (DIN)
unnamed: D95.1 (DOUT), D96.3 (DIN)
unnamed: D96.1 (DOUT), D97.3 (DIN)
unnamed: D97.1 (DOUT), D98.3 (DIN)
unnamed: D98.1 (DOUT), D99.3 (DIN)
unnamed: D100.1 (DOUT), D101.3 (DIN)
unnamed: D99.1 (DOUT), D100.3 (DIN)
unnamed: D101.1 (DOUT), D102.3 (DIN)
unnamed: D102.1 (DOUT), D103.3 (DIN)
unnamed: D103.1 (DOUT), D104.3 (DIN)
unnamed: D104.1 (DOUT), D105.3 (DIN)
unnamed: D105.1 (DOUT), D106.3 (DIN)
unnamed: D106.1 (DOUT), D107.3 (DIN)
unnamed: D107.1 (DOUT), D108.3 (DIN)
unnamed: D108.1 (DOUT), D109.3 (DIN)
unnamed: D109.1 (DOUT), D110.3 (DIN)
unnamed: D110.1 (DOUT), D111.3 (DIN)
unnamed: D111.1 (DOUT), D112.3 (DIN)
unnamed: D112.1 (DOUT), D113.3 (DIN)
unnamed: D113.1 (DOUT), D114.3 (DIN)
unnamed: D114.1 (DOUT), D115.3 (DIN)
unnamed: D115.1 (DOUT), D116.3 (DIN)
unnamed: D116.1 (DOUT), D117.3 (DIN)
unnamed: D117.1 (DOUT), D118.3 (DIN)
unnamed: D118.1 (DOUT), D119.3 (DIN)
unnamed: D119.1 (DOUT), D120.3 (DIN)
unnamed: D120.1 (DOUT), D121.3 (DIN)
unnamed: D121.1 (DOUT), D122.3 (DIN)
unnamed: D122.1 (DOUT), D123.3 (DIN)
unnamed: D123.1 (DOUT), D124.3 (DIN)
unnamed: D124.1 (DOUT), D125.3 (DIN)
unnamed: D125.1 (DOUT), D126.3 (DIN)
unnamed: D126.1 (DOUT), D127.3 (DIN)
unnamed: D127.1 (DOUT), D128.3 (DIN)
unnamed: D128.1 (DOUT), D129.3 (DIN)
unnamed: D129.1 (DOUT), D130.3 (DIN)
unnamed: D130.1 (DOUT), D131.3 (DIN)
unnamed: D131.1 (DOUT), D132.3 (DIN)
unnamed: D132.1 (DOUT), D133.3 (DIN)
unnamed: D133.1 (DOUT), D134.3 (DIN)
unnamed: D134.1 (DOUT), D135.3 (DIN)
unnamed: D135.1 (DOUT), D136.3 (DIN)
unnamed: D136.1 (DOUT), D137.3 (DIN)
unnamed: D137.1 (DOUT), D138.3 (DIN)
unnamed: D138.1 (DOUT), D139.3 (DIN)
unnamed: D139.1 (DOUT), D140.3 (DIN)
unnamed: D140.1 (DOUT), D141.3 (DIN)
unnamed: D141.1 (DOUT), D142.3 (DIN)
unnamed: D142.1 (DOUT), D143.3 (DIN)
unnamed: D143.1 (DOUT), D144.3 (DIN)
unnamed: D144.1 (DOUT), D145.3 (DIN)
unnamed: D146.1 (DOUT), D147.3 (DIN)
unnamed: D147.1 (DOUT), D148.3 (DIN)
unnamed: D148.1 (DOUT), D149.3 (DIN)
unnamed: D149.1 (DOUT), D150.3 (DIN)
unnamed: D150.1 (DOUT), D151.3 (DIN)
unnamed: D151.1 (DOUT), D152.3 (DIN)
unnamed: D152.1 (DOUT), D153.3 (DIN)
unnamed: D153.1 (DOUT), D154.3 (DIN)
unnamed: D154.1 (DOUT), D155.3 (DIN)
unnamed: D155.1 (DOUT), D156.3 (DIN)
unnamed: D156.1 (DOUT), D157.3 (DIN)
unnamed: D157.1 (DOUT), D158.3 (DIN)
unnamed: D158.1 (DOUT), D159.3 (DIN)
unnamed: D159.1 (DOUT), D160.3 (DIN)
unnamed: D160.1 (DOUT), D161.3 (DIN)
unnamed: D161.1 (DOUT), D162.3 (DIN)
unnamed: D162.1 (DOUT), D163.3 (DIN)
unnamed: D163.1 (DOUT), D164.3 (DIN)
unnamed: D164.1 (DOUT), D165.3 (DIN)
unnamed: D165.1 (DOUT), D166.3 (DIN)
unnamed: D166.1 (DOUT), D167.3 (DIN)
unnamed: D167.1 (DOUT), D168.3 (DIN)
unnamed: D168.1 (DOUT), D169.3 (DIN)
unnamed: D169.1 (DOUT), D170.3 (DIN)
unnamed: D170.1 (DOUT), D171.3 (DIN)
unnamed: D171.1 (DOUT), D172.3 (DIN)
unnamed: D172.1 (DOUT), D173.3 (DIN)
unnamed: D173.1 (DOUT), D174.3 (DIN)
unnamed: D174.1 (DOUT), D175.3 (DIN)
unnamed: D175.1 (DOUT), D176.3 (DIN)
unnamed: D176.1 (DOUT), D177.3 (DIN)
unnamed: D177.1 (DOUT), D178.3 (DIN)
unnamed: D178.1 (DOUT), D179.3 (DIN)
unnamed: D179.1 (DOUT), D180.3 (DIN)
unnamed: D180.1 (DOUT), D181.3 (DIN)
unnamed: D181.1 (DOUT), D182.3 (DIN)
unnamed: D182.1 (DOUT), D183.3 (DIN)
unnamed: D183.1 (DOUT), D184.3 (DIN)
unnamed: D184.1 (DOUT), D185.3 (DIN)
unnamed: D185.1 (DOUT), D186.3 (DIN)
unnamed: D186.1 (DOUT), D187.3 (DIN)
unnamed: D187.1 (DOUT), D188.3 (DIN)
unnamed: D188.1 (DOUT), D189.3 (DIN)
unnamed: D189.1 (DOUT), D190.3 (DIN)
unnamed: D190.1 (DOUT), D191.3 (DIN)
unnamed: D191.1 (DOUT), D192.3 (DIN)
unnamed: D192.1 (DOUT), D193.3 (DIN)
unnamed: D193.1 (DOUT), D194.3 (DIN)
unnamed: D194.1 (DOUT), D195.3 (DIN)
unnamed: D195.1 (DOUT), D196.3 (DIN)
unnamed: D196.1 (DOUT), D197.3 (DIN)
unnamed: D197.1 (DOUT), D198.3 (DIN)
unnamed: D198.1 (DOUT), D199.3 (DIN)
unnamed: D199.1 (DOUT), D200.3 (DIN)
unnamed: D200.1 (DOUT), D201.3 (DIN)
unnamed: D201.1 (DOUT), D202.3 (DIN)
unnamed: D202.1 (DOUT), D203.3 (DIN)
unnamed: D203.1 (DOUT), D204.3 (DIN)
unnamed: D204.1 (DOUT), D205.3 (DIN)
unnamed: D205.1 (DOUT), D206.3 (DIN)
unnamed: D206.1 (DOUT), D207.3 (DIN)
unnamed: D207.1 (DOUT), D208.3 (DIN)
unnamed: J0.A5 (CC1), R0.2
unnamed: J0.A6 (D+), J0.B6 (D+), U0.5 (UD+)
unnamed: J0.A7 (D-), J0.B7 (D-), U0.6 (UD-)
unnamed: J0.B5 (CC2), R3.2
unnamed: Q0.1 (B), R4.2
unnamed: Q0.2 (E), R5.1, U0.14 (~RTS)
unnamed: Q1.1 (B), R5.2
unnamed: Q1.2 (E), R4.1, U0.13 (~DTR)
unnamed: R1.1, U0.2 (TXD)
unnamed: R2.1, U0.3 (RXD)
unnamed: R6.2, U2.3 (EN)
unnamed: R7.1, U2.17 (GPIO2)
unnamed: R8.2, U3.4 (B)
unnamed: R9.1, U2.16 (GPIO15)
VBUS: C1.1, D0.2 (A), J0.A4 (VBUS), J0.A9 (VBUS), J0.B4 (VBUS), J0.B9 (VBUS)
esp-gpio0: Q1.3 (C), U2.18 (GPIO0)
esp-rst: Q0.3 (C), U2.1 (~RST)
rxd-to-tx: R2.2, U2.22 (GPIO1/TXD)
txd-to-rx: R1.2, U2.21 (GPIO3/RXD)
