LArkema/dctransistor-project/DCTransistor-Bidirectional/config.h

/*
*   CONFIGURATION FILE FOR DCTRANSISTOR BINARY
*
*   Arranged by configuration values most likely to be relevant to users    
*   Followed by debug values 
*   Followed by values that may occasionally change, but are still required
*   Followed by required values
*
*   (c) Logan Arkema 2025
*/

//Include Standard and Custom libraries and classes
#include <Arduino.h>
#include <ArduinoJson.h>
#include <Adafruit_NeoPixel.h>
#include <WiFiManager.h>
#include <ESP8266WiFi.h>
#include <ESP8266HTTPClient.h>
#include <ESP8266httpUpdate.h>
#include <time.h>

//Version string. Changes with every software version
#define VERSION "2.0.82"

/*
*   USER CONFIGURATION VALUES
*/

//Whether or not to check for automatic updates every time board powers on (turning to false may break board when web TLS certificates expire)
#define AUTOUPDATE true

//Uncomment below line to print program text output to Serial output (requires attaching board to computer via USB cable)
//#define PRINT true

//Set wait times for different (roughly) time-based events
#define WAIT_SEC 1 //Number of seconds to wait between requests to WMATA server (WMATA updates every ~20, per documentation)
#define CYCLES_AT_END 20 //Number of cycles to keep LED for last train on after arrival
#define SPECIAL_TRAIN_CHECK_HOURS 1 //Number of hours to see if there is a new TrainID for special train (updates every day or so)
#define UPDATE_CHECK_HOURS 24 //Number of hours to see if new board update

//Name of WiFi Network (SSID) Board Creates when unable to connect to wifi
#define WIFI_NAME "DCTransistor"
#define WIFI_PASSWORD "trainsareneat"

// ----  LED Configuration Values ----
#define LED_BRIGHTNESS 3 //Range of 0-100. Can get very bright very fast

//Define LED color for each train line. Defined as WWRRGGBB values where white (first byte) is always set to 0.
//Pick own colors using a tool like https://www.w3schools.com/colors/colors_picker.asp
#define RD_HEX_COLOR 0x00FF0000 
#define BL_HEX_COLOR 0x000000FF
#define OR_HEX_COLOR 0x00FF4000
#define SV_HEX_COLOR 0x00808080
#define YL_HEX_COLOR 0x00FFFF00
#define GN_HEX_COLOR 0x0000FF00

// LED Colors for Special Trains
#define CH_BLOSSOM_HEX_COLOR 0x00F17EB1 // Cherry Blossom
#define PURPLE_HEX_COLOR 0x00FF00FF//0x0099CCFF //0x00722A82 //Pride
#define TEAL_HEX_COLOR 0x007ACFE7 //Pride
#define PINK_HEX_COLOR 0x00FF66FF //0x00F5ACC5 //Pride
//#define BROWN_HEX_COLOR 0x00998833//0x00603A17 //Pride

// Led Configuration for special promotional trains. Will only show up if campaign is active

// Holidays Special Trains
// #define SPECIAL_TRAIN_HEX_COUNT 2
// const uint32_t SPECIAL_TRAIN_HEX[SPECIAL_TRAIN_HEX_COUNT] = {RD_HEX_COLOR, GN_HEX_COLOR};

// 4th of July Special Trains
#define SPECIAL_TRAIN_HEX_COUNT 3
const uint32_t SPECIAL_TRAIN_HEX[SPECIAL_TRAIN_HEX_COUNT] = {RD_HEX_COLOR, SV_HEX_COLOR, BL_HEX_COLOR};

// Pride Special Train
// #define SPECIAL_TRAIN_HEX_COUNT 8
// const uint32_t SPECIAL_TRAIN_HEX[SPECIAL_TRAIN_HEX_COUNT] = {RD_HEX_COLOR, OR_HEX_COLOR, YL_HEX_COLOR, GN_HEX_COLOR, BL_HEX_COLOR, PURPLE_HEX_COLOR, TEAL_HEX_COLOR, PINK_HEX_COLOR}; //Pride

// Cherry Blossom Special Train
//#define SPECIAL_TRAIN_HEX_COUNT 1
//const uint32_t SPECIAL_TRAIN_HEX[SPECIAL_TRAIN_HEX_COUNT] = {CH_BLOSSOM_HEX_COLOR};




/*
*   DEBUG CONFIGURATION VALUES
*/

//JSON document sizes must be predefined, and may need to be increased if amount of data increases
#define JSON_FILTER_SIZE 255 //Bytes of filter to apply to JSON data returned from WMATA
#define JSON_DOC_SIZE 1024 //Bytes of parsed and filtered JSON data returned from WMATA (All trian line, position, and circuitIDs). 8096 -> 8096. 20000 -> 0 HTTP:22820 16000 -> 16000


/*
*   OCCASIONALLY CHANGING VALUES
*/

// VERSION 1.0 / API DATA SOURCE VALUES

// #define SECRET_WMATA_API_KEY_0 "0123456789abcdef0123456789abcdef"
// #define SECRET_WMATA_API_KEY_1 "123456789abcdef0123456789abcdef0"
// #define SECRET_WMATA_API_KEY_2 "2123456789abcdef0123456789abcdef"


//Web server certificate SHA1 fingerprints for TLS connections. Updated daily by update-fingerprints action
#define GITHUB_COM_FINGERPRINT "E6 52 C8 BD 1C AF D0 4A 44 23 9F A8 DA B0 C5 9D EA CB 79 EE"
#define RAW_GITHUBUSERCONTENT_COM_FINGERPRINT "14 2D 52 A3 EC DB FE 52 FF F8 99 66 A8 A7 44 D1 71 99 8B CB"
#define API_WMATA_COM_FINGERPRINT "22 88 A6 97 85 31 DD B6 A4 FD EE FB 16 1F A2 31 EC 21 11 F8"
#define GIS_WMATA_COM_FINGERPRINT "D8 78 06 04 9D 03 2A 5B FA 9C 42 BF 9D 8B 5D CB 18 80 C6 E7"
#define GISSERVICES_WMATA_COM_FINGERPRINT "D8 78 06 04 9D 03 2A 5B FA 9C 42 BF 9D 8B 5D CB 18 80 C6 E7"

/*
*   REQUIRED CONFIGURATION VALUES
*   (Things will break or not work right if changed)
*/

//Headers to grab from response to request to /releases/latest (returns redirect to URL containing version umber)
const char* github_header_keys[] = {"location"};
const int github_num_headers = 1;

//URLs and remote hosts for software updates and WMATA data
#define LATEST_VERSION_URL "https://github.com/LArkema/dctransistor-project/releases/latest"
#define UPDATE_BIN_URL "https://raw.githubusercontent.com/LArkema/dctransistor-project/main/dctransistor-bidirectional.bin.gz"
#define UPDATE_HOST "raw.githubusercontent.com"
#define GITHUB_HOST "github.com"

#define WMATA_ENDPOINT "https://api.wmata.com/TrainPositions/TrainPositions?contentType=json"
#define GIS_CONFIG_ENDPOINT "https://gis.wmata.com/live/appconfig.json"
#define GIS_SPECIAL_TRAIN_ENDPOINT "https://gis.wmata.com/proxy/proxy.ashx?https://gispro.wmata.com/RpmSpecialTrains/api/SpcialTrain"
#define GIS_TRAIN_LOC_ENDPOINT "https://gisservices.wmata.com/gisservices/rest/services/Public/TRAIN_LOC_WMS_PUB/MapServer/2/query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*"
#define HTTPS_PORT 443

/*
* REQUIRED TO SET TO CHOOSE BETWEEN DATA SOURCES
*/

#define DATA_SOURCE_ENDPOINT GIS_TRAIN_LOC_ENDPOINT
#define DATA_SOURCE_FINGERPRINT GISSERVICES_WMATA_COM_FINGERPRINT

//Frequency for sending debug messages from ESP8266 chip to computer
#define BAUD_RATE 9600

// ----- LED CONFIGURATIONS ----
//configurations for chained together WS2812B LEDS. Datasheet: https://cdn-shop.adafruit.com/datasheets/WS2812B.pdf
#define LED_PIN  4 //GPIO pin sending data to 1st WS2812B LED
#define LED_COUNT 207 //total # LEDs 
#define PWR_LED 206 //index of "Power" (should be last)
#define WIFI_LED 205 //indoex of "WiFi" (2nd to last)
#define WEB_LED 204 //index of "Web" (3rd to last)

// Number of circuits before a Station's exact circuit to count a train as "at" that station
#define CIRCS_BEFORE_STATION 2

// ----- TRAIN LINE CONFIGURATIONS -----

/*
Each line is defined by the number of stations on the line, the color trains on that line should be as a WRGB 32-bit hex value,
And two arrays of circuit indecies that correlate with each station on that line (defined by WMATA).

stations_0 is for trains (generally) moving North / East and is Direction 1 in WMATA products.
stations_1 is for trains (generally) moving South / West and is Direction 2 in WMATA products.
The arrays are ordered IN THE DIRECTION THE TRAIN MOVES, 
so the first station circuit in one direction represents the same station as the last station circuit in the other direction

See misc_commands.sh for how each array was created from WMATA's information
*/

#define TOTAL_SYSTEM_STATIONS 204 //Includes 2 stations for intersections (not in LED count) and future stations.

#define NUM_LINES 6

// Set number of stations per line
#define NUM_RD_STATIONS 27
#define NUM_BL_STATIONS 28
#define NUM_OR_STATIONS 26
#define NUM_SV_STATIONS 34
#define NUM_YL_STATIONS 13  
#define NUM_GN_STATIONS 21

// Station Codes for each station on each line. Code is prefixed in "TRKID" response from GIS Server.

//Exceptions: "B99" - Map to NoMa (B35)
const char* rstation_codes[NUM_RD_STATIONS] = {"A15", "A14", "A13", "A12", "A11", "A10", "A09", "A08", "A07", "A06", "A05", "A04", "A03", "A02", "A01", "B01", "B02", "B03", "B35", "B04", "B05", "B06", "B07", "B08", "B09", "B10", "B11"};
#define RD_END_TRK_0 719  // Was 382 
#define RD_END_TRK_1 942

//Exceptions: "J01 & C98 - Van Dorn (J02), C97 - King St. (C13), D98 - Benning Road (G01)"
const char* bstation_codes[NUM_BL_STATIONS] = {"J03", "J02", "C13", "C12", "C11", "C10", "C09", "C08", "C07", "C06", "C05", "C04", "C03", "C02", "C01", "D01", "D02", "D03", "D04", "D05", "D06", "D07", "D08", "G01", "G02", "G03", "G04", "G05"};
#define BL_END_TRK_0 623
#define BL_END_TRK_1 881

//Exceptions: "K98 - West Falls Church (K06), D98 - Minnesota Ave (D09)"
const char* ostation_codes[NUM_OR_STATIONS] = {"K08", "K07", "K06", "K05", "K04", "K03", "K02", "K01", "C05", "C04", "C03", "C02", "C01", "D01", "D02", "D03", "D04", "D05", "D06", "D07", "D08", "D09", "D10", "D11", "D12", "D13"};
#define OR_END_TRK_0 594
#define OR_END_TRK_1 783

//Exceptions: "N05, N98A & N98B, N98, N96, N97, N96, N94, N95, N94, N93, N92, N91, K98 - McLean (N01), D98"
const char* sstation_codes[NUM_SV_STATIONS] = {"N12", "N11", "N10", "N09", "N08", "N07", "N06", "N04", "N03", "N02", "N01", "K05", "K04", "K03", "K02", "K01", "C05", "C04", "C03", "C02", "C01", "D01", "D02", "D03", "D04", "D05", "D06", "D07", "D08", "G01", "G02", "G03", "G04", "G05"};
#define SV_END_TRK_0 623
#define SV_END_TRK_1 1664

//Exceptions: "C97 - King St. (C13)"
const char* ystations_codes[NUM_YL_STATIONS] = {"C15", "C14", "C13", "C12", "C11", "C10", "C09", "C08", "C07", "F03", "F02", "F01", "E01"};
#define YL_END_TRK_0 37
#define YL_END_TRK_1 623

// No exceptions
const char* gstation_codes[NUM_GN_STATIONS] = {"F11", "F10", "F09", "F08", "F07", "F06", "F05", "F04", "F03", "F02", "F01", "E01", "E02", "E03", "E04", "E05", "E06", "E07", "E08", "E09", "E10"};
#define GN_END_TRK_0 662
#define GN_END_TRK_1 540

/*
*
* VERSION 1.0 TRACK CIRCUIT IDS
*
*/


//Red Line
// const uint16_t rstations_0[NUM_RD_STATIONS] = {7, 32, 53, 62, 80, 95, 109, 126, 133, 142, 154, 164, 179, 190, 203, 467, 477, 485, 496, 513, 527, 548, 571, 591, 611, 629, 652};
// const uint16_t rstations_1[NUM_RD_STATIONS] = {868, 846, 828, 809, 785, 757, 731, 717, 700, 686, 677, 667, 661, 389, 378, 363, 356, 346, 336, 326, 309, 294, 278, 260, 251, 232, 210};

// //Blue Line
// const uint16_t bstations_0[NUM_BL_STATIONS] = {2604, 2634, 969, 976, 991, 1010, 1024, 1036, 1052, 1070, 1092, 1105, 1117, 1126, 1135, 1384, 1393, 1400, 1406, 1418, 1424, 1436, 1443, 2420, 2434, 2449, 2469, 2487};
// const uint16_t bstations_1[NUM_BL_STATIONS] = {2574, 2557, 2537, 2521, 2506, 1618, 1610, 1598, 1590, 1575, 1568, 1559, 1549, 1330, 1323, 1310, 1298, 1285, 1265, 1246, 1230, 1217, 1204, 1187, 1170, 1162, 2709, 2679};

// //Orange line
// const uint16_t ostations_0[NUM_OR_STATIONS] = {2774, 2796, 2817, 2844, 2870, 2886, 2898, 2911, 1092, 1105, 1117, 1126, 1135, 1384, 1393, 1400, 1406, 1418, 1424, 1436, 1443, 1475, 1487, 1500, 1522, 1542};
// const uint16_t ostations_1[NUM_OR_STATIONS] = {1711, 1692, 1670, 1657, 1643, 1618, 1610, 1598, 1590, 1575, 1568, 1559, 1549, 1330, 1323, 1310, 1298, 1285, 3061, 3048, 3037, 3023, 3001, 2976, 2954, 2933};

// //Silver Line
// const uint16_t sstations_0[NUM_SV_STATIONS] = {3523, 3544, 3577, 3594, 3612, 3627, 3155, 3214, 3221, 3232, 3238, 2844, 2870, 2886, 2898, 2911, 1092, 1105, 1117, 1126, 1135, 1384, 1393, 1400, 1406, 1418, 1424, 1436, 1443, 2420, 2434, 2449, 2469, 2487};
// const uint16_t sstations_1[NUM_SV_STATIONS] = {2574, 2557, 2537, 2521, 2506, 1618, 1610, 1598, 1590, 1575, 1568, 1559, 1549, 1330, 1323, 1310, 1298, 1285, 3061, 3048, 3037, 3023, 3001, 3377, 3370, 3359, 3352, 3290, 3741, 3724, 3706, 3689, 3657, 3637};

// //Yellow Line
//              // !! PENTAGON & L'ENFANT STATION INDEXES AND BRIDGE CIRCUITS ARE HARDCODED IN setTrainState !!
// const uint16_t ystations_0[NUM_YL_STATIONS] = {944, 955, 969, 976, 991, 1010, 1024, 1036, 1052, 2231, 2241, 2246, 1753, 1764};
// const uint16_t ystations_1[NUM_YL_STATIONS] = {1923, 1911, 1899, 2376, 2364, 1246, 1230, 1217, 1204, 1187, 1170, 1162, 1148, 1137};

// //Green Line
// const uint16_t gstations_0[NUM_GN_STATIONS] = {2118, 2136, 2154, 2170, 2183, 2199, 2208, 2219, 2231, 2241, 2246, 1753, 1764, 1773, 1782, 1796, 1809, 1833, 1850, 1871, 1894};
// const uint16_t gstations_1[NUM_GN_STATIONS] = {2055, 2030, 2009, 1992, 1971, 1956, 1942, 1932, 1923, 1911, 1899, 2376, 2364, 2352, 2342, 2333, 2317, 2303, 2291, 2272, 2255};


//LED arrays map each line's stations, in the same order as stations_0, to the index of that station in the continuous "string" of LEDs.

const uint8_t rd_led_array_0[NUM_RD_STATIONS] = {0, 3, 4, 7, 8, 11, 12, 14, 17, 18, 21, 22, 25, 26, 28, 30, 33, 34, 37, 38, 41, 43, 44, 47, 48, 51, 52};
const uint8_t rd_led_array_1[NUM_RD_STATIONS] = {1, 2, 5, 6, 9, 10, 13, 15, 16, 19, 20, 23, 24, 27, 29, 31, 32, 35, 36, 39, 40, 42, 45, 46, 49, 50, 53};
//const uint8_t rd_led_array_1[NUM_RD_STATIONS] = {53, 50, 49, 46, 45, 42, 40, 39, 36, 35, 32, 31, 29, 27, 24, 23, 20, 19, 16, 15, 13, 10, 9, 6, 5, 2, 1};

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
, 2432, 2433, 2434, 2435, 2436, 2437, 2438, 2439, 2440, 2441, 2442, 2443, 2444, 2445, 2446, 2447, 2448, 2449, 2450, 2451, 2452, 2453, 2454, 2455, 2456, 2457, 2458, 2459, 2460, 2461, 2462, 2463, 2464, 2465, 2466, 2467, 2468, 2469, 2470, 2471, 2472, 2473, 2474, 2475, 2476, 2477, 2478, 2479, 2480, 2481, 2482, 2483, 2484, 2485, 2486, 2487, 2488};
//const uint16_t SV_LINE_CIRCUITS_1[557] = {3631, 3632, 3633, 3634, 3635, 3636, 3637, 3638, 3639, 3640, 3641, 3642, 3643, 3644, 3645, 3646, 3647, 3648, 3649, 3650, 3651, 3652, 3653, 3654, 3655, 3656, 3657, 3658, 3659, 3660, 3661, 3662, 3663, 3664, 3665, 3666, 3667, 3668, 3669, 3670, 3671, 3672, 3673, 3674, 3675, 3676, 3677, 3678, 3679, 3680, 3681, 3682, 3683, 3684, 3685, 3686, 3687, 3688, 3689, 3690, 3691, 3692, 3693, 3694, 3695, 3696, 3697, 3698, 3699, 3700, 3701, 3702, 3703, 3704, 3705, 3706, 3707, 3708, 3709, 3710, 3711, 3712, 3713, 3714, 3715, 3716, 3717, 3718, 3719, 3720, 3721, 3722, 3723, 3724, 3725, 3726, 3727, 3728, 3729, 3730, 3731, 3732, 3733, 3734, 3735, 3736, 3737, 3738, 3739, 3740, 3741, 3742, 3743, 3744, 3281, 3289, 3290, 3291, 3292, 3293, 3294, 3295, 3296, 3297, 3298, 3299, 3300, 3301, 3302, 3303, 3304, 3305, 3306, 3307, 3308, 3309, 3310, 3311, 3312, 3313, 3314, 3315, 3316, 3317, 3318, 3319, 3320, 3321, 3322, 3323, 3324, 3325, 3326, 3327, 3328, 3329, 3330, 3331, 3332, 3333, 3334, 3335, 3336, 3337, 3338, 3339, 3340, 3341, 3342, 3343, 3344, 3345, 3346, 3347, 3348, 3349, 3350, 3351, 3352, 3353, 3354, 3355, 3356, 3357, 3358, 3359, 3360, 3361, 3362, 3363, 3364, 3365, 3366, 3367, 3368, 3369, 3370, 3371, 3372, 3373, 3374, 3375, 3376, 3377, 3378, 3379, 3380, 3381, 3382, 3383, 3384, 3385, 3386, 3387, 3388, 3389, 3390, 3391, 3392, 3393, 3394, 3395, 3396, 3397, 3398, 3399, 3400, 3401, 3402, 3403, 3404, 3405, 3406, 3407, 3408, 3409, 3410, 3411, 3412, 3413, 3414, 3415, 3416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
