LArkema/dctransistor-project/Setup-Bidirectional/Setup-Bidirectional.ino

#include <Adafruit_NeoPixel.h>
#include <WiFiManager.h>
#include <ESP8266WiFi.h>
#include <ESP8266HTTPClient.h>
#include <ESP8266httpUpdate.h>

#define WIFI_NAME "DCTransistor"
#define WIFI_PASSWORD "trainsareneat"

#define UPDATE_BIN_URL "https://raw.githubusercontent.com/LArkema/dctransistor-project/main/dctransistor-bidirectional.bin.gz"
#define UPDATE_HOST "raw.githubusercontent.com"
#define HTTPS_PORT 443

#define LED_PIN  4 //GPIO pin sending data to 1st WS2812B LED
#define LED_COUNT 207 //total # LEDs
#define PWR_LED 206 //index of "Power" (should be last)
#define WIFI_LED 205 //indoex of "WiFi" (2nd to last) 
#define WEB_LED 204//index of "Web" (3rd to last)

#define RD_HEX_COLOR 0x00FF0000 
#define BL_HEX_COLOR 0x000000FF
#define YL_HEX_COLOR 0x00FFFF00
#define GN_HEX_COLOR 0x0000FF00
#define LED_BRIGHTNESS 10

WiFiManager wifi_manager;WiFiClientSecure client;
HTTPClient https;

Adafruit_NeoPixel strip(LED_COUNT, LED_PIN, NEO_GRB + NEO_KHZ800); //object to control colors of all LEDs (i.e. a "strip" of WS2812Bs)


void update_arduino(){

  strip.setPixelColor(WEB_LED, BL_HEX_COLOR);
  strip.show();

  //client.setFingerprint(RAW_GITHUBUSERCONTENT_COM_FINGERPRINT);
  
  //Download w/o validating cert to not have to manage fingerprints.
  client.setInsecure(); 
  client.connect(UPDATE_HOST, HTTPS_PORT);
  
  t_httpUpdate_return ret = ESPhttpUpdate.update(client, UPDATE_BIN_URL);

   switch (ret) {
      case HTTP_UPDATE_FAILED: Serial.printf("HTTP_UPDATE_FAILED Error (%d): %s\n", ESPhttpUpdate.getLastError(), ESPhttpUpdate.getLastErrorString().c_str()); strip.setPixelColor(WEB_LED, RD_HEX_COLOR); break;

      case HTTP_UPDATE_NO_UPDATES: Serial.println("HTTP_UPDATE_NO_UPDATES"); break;

      case HTTP_UPDATE_OK: Serial.println("HTTP_UPDATE_OK"); strip.setPixelColor(WEB_LED, GN_HEX_COLOR); break;
    } 

}//END update_arduino


void setup() {
  Serial.begin(9600);

  //Set LED strip settings and turn power light on
  strip.begin();
  strip.setBrightness(LED_BRIGHTNESS);
  strip.setPixelColor(PWR_LED,GN_HEX_COLOR);
  strip.show();

  //Connect to network configured by user throug WiFi Manager
  strip.setPixelColor(WIFI_LED, YL_HEX_COLOR);
  strip.show();

  //Setup WiFi connection
  bool wifi_conn;
  wifi_conn = wifi_manager.autoConnect(WIFI_NAME, WIFI_PASSWORD);

  if(wifi_conn){
    strip.setPixelColor(WIFI_LED, GN_HEX_COLOR);
    strip.show();
  }

  update_arduino();
} //END SETUP

//If Download and flash fails, do color loop
void loop() {
  // Fill along the length of the strip in various colors...
  colorWipe(strip.Color(255,   0,   0)     , 50); // Red
  colorWipe(strip.Color(  0, 255,   0)     , 50); // Green
  colorWipe(strip.Color(  0,   0, 255)     , 50); // Blue
  colorWipe(strip.Color(  0,   0,   0, 255), 50); // True white (not RGB white)

  whiteOverRainbow(75, 5);

  pulseWhite(5);

  rainbowFade2White(3, 3, 1);
}

// Fill strip pixels one after another with a color. Strip is NOT cleared
// first; anything there will be covered pixel by pixel. Pass in color
// (as a single 'packed' 32-bit value, which you can get by calling
// strip.Color(red, green, blue) as shown in the loop() function above),
// and a delay time (in milliseconds) between pixels.
void colorWipe(uint32_t color, int wait) {
  for(int i=0; i<strip.numPixels(); i++) { // For each pixel in strip...
    strip.setPixelColor(i, color);         //  Set pixel's color (in RAM)
    strip.show();                          //  Update strip to match
    delay(wait);                           //  Pause for a moment
  }
}

void whiteOverRainbow(int whiteSpeed, int whiteLength) {

  if(whiteLength >= strip.numPixels()) whiteLength = strip.numPixels() - 1;

  int      head          = whiteLength - 1;
  int      tail          = 0;
  int      loops         = 3;
  int      loopNum       = 0;
  uint32_t lastTime      = millis();
  uint32_t firstPixelHue = 0;

  for(;;) { // Repeat forever (or until a 'break' or 'return')
    for(int i=0; i<strip.numPixels(); i++) {  // For each pixel in strip...
      if(((i >= tail) && (i <= head)) ||      //  If between head & tail...
         ((tail > head) && ((i >= tail) || (i <= head)))) {
        strip.setPixelColor(i, strip.Color(0, 0, 0, 255)); // Set white
      } else {                                             // else set rainbow
        int pixelHue = firstPixelHue + (i * 65536L / strip.numPixels());
        strip.setPixelColor(i, strip.gamma32(strip.ColorHSV(pixelHue)));
      }
    }

    strip.show(); // Update strip with new contents
    // There's no delay here, it just runs full-tilt until the timer and
    // counter combination below runs out.

    firstPixelHue += 40; // Advance just a little along the color wheel

    if((millis() - lastTime) > whiteSpeed) { // Time to update head/tail?
      if(++head >= strip.numPixels()) {      // Advance head, wrap around
        head = 0;
        if(++loopNum >= loops) return;
      }
      if(++tail >= strip.numPixels()) {      // Advance tail, wrap around
        tail = 0;
      }
      lastTime = millis();                   // Save time of last movement
    }
  }
}

void pulseWhite(uint8_t wait) {
  for(int j=0; j<256; j++) { // Ramp up from 0 to 255
    // Fill entire strip with white at gamma-corrected brightness level 'j':
    strip.fill(strip.Color(0, 0, 0, strip.gamma8(j)));
    strip.show();
    delay(wait);
  }

  for(int j=255; j>=0; j--) { // Ramp down from 255 to 0
    strip.fill(strip.Color(0, 0, 0, strip.gamma8(j)));
    strip.show();
    delay(wait);
  }
}

void rainbowFade2White(int wait, int rainbowLoops, int whiteLoops) {
  int fadeVal=0, fadeMax=100;

  // Hue of first pixel runs 'rainbowLoops' complete loops through the color
  // wheel. Color wheel has a range of 65536 but it's OK if we roll over, so
  // just count from 0 to rainbowLoops*65536, using steps of 256 so we
  // advance around the wheel at a decent clip.
  for(uint32_t firstPixelHue = 0; firstPixelHue < rainbowLoops*65536;
    firstPixelHue += 256) {

    for(int i=0; i<strip.numPixels(); i++) { // For each pixel in strip...

      // Offset pixel hue by an amount to make one full revolution of the
      // color wheel (range of 65536) along the length of the strip
      // (strip.numPixels() steps):
      uint32_t pixelHue = firstPixelHue + (i * 65536L / strip.numPixels());

      // strip.ColorHSV() can take 1 or 3 arguments: a hue (0 to 65535) or
      // optionally add saturation and value (brightness) (each 0 to 255).
      // Here we're using just the three-argument variant, though the
      // second value (saturation) is a constant 255.
      strip.setPixelColor(i, strip.gamma32(strip.ColorHSV(pixelHue, 255,
        255 * fadeVal / fadeMax)));
    }

    strip.show();
    delay(wait);

    if(firstPixelHue < 65536) {                              // First loop,
      if(fadeVal < fadeMax) fadeVal++;                       // fade in
    } else if(firstPixelHue >= ((rainbowLoops-1) * 65536)) { // Last loop,
      if(fadeVal > 0) fadeVal--;                             // fade out
    } else {
      fadeVal = fadeMax; // Interim loop, make sure fade is at max
    }
  }

  for(int k=0; k<whiteLoops; k++) {
    for(int j=0; j<256; j++) { // Ramp up 0 to 255
      // Fill entire strip with white at gamma-corrected brightness level 'j':
      strip.fill(strip.Color(0, 0, 0, strip.gamma8(j)));
      strip.show();
    }
    delay(1000); // Pause 1 second
    for(int j=255; j>=0; j--) { // Ramp down 255 to 0
      strip.fill(strip.Color(0, 0, 0, strip.gamma8(j)));
      strip.show();
    }
  }

  delay(500); // Pause 1/2 second
}
