LArkema/dctransistor-project/initial_arduino/initial_arduino.ino

/*
 * Initial Arduino for WMATA_PCB project
 * Based on BasicHTTPSClient.ino in ESP8266 example sketches
 * Main difference is connection to api.wmata.com with api_key header,
 * and getting WMATA API data for a single station
 * Logan Arkema, 10/22/2021
*/


#include <ESP8266WiFi.h>
#include <ESP8266WiFiMulti.h>
#include <ESP8266HTTPClient.h>
#include "arduino_secrets.h"

char* ssid = SECRET_SSID;
const char* password = SECRET_PASS; 
const char* wmata_fingerprint = "D2 1C A6 D1 BE 10 18 B3 74 8D A2 F5 A2 DE AB 13 7D 07 63 BE"; //Expires 10/22/2022 
String wmata_host = "https://api.wmata.com";

ESP8266WiFiMulti WiFiMulti;

void setup() {
  Serial.begin(9600); //NodeMCU ESP8266 runs on 9600 baud rate

  //Limit WiFi to station mode and connect to network defined in arduino_secrets.h
  WiFi.mode(WIFI_STA);
  WiFiMulti.addAP(ssid, password);

  //Connect to WiFi
  while (WiFiMulti.run() != WL_CONNECTED){
    delay(1000);
    Serial.println("Connecting to WiFi...");
  }
  Serial.println("Wifi Connected");
  
}

// the loop function runs over and over again forever
void loop() {

  //Define client responsible for managing secure connection api.wmata.com
  WiFiClientSecure client;
  client.setFingerprint(wmata_fingerprint);
  client.setTimeout(15000);

  HTTPClient https;

  //Define URL for GET request and confirm correctness
  String station_code = "A01";
  String wmata_endpoint = wmata_host + "/StationPrediction.svc/json/GetPrediction/" + station_code;

  //Connect and confirm HTTPS connection to api.wmata.com
  if (https.begin(client, wmata_endpoint)) {
    
    //If successful, add API key and request station data
    https.addHeader("api_key", SECRET_WMATA_API_KEY);
    int httpCode = https.GET();

    //Print out HTTP code and, if successful, JSON station data
    if (httpCode > 0) {
      String payload = https.getString();
      Serial.println(httpCode);
      Serial.println(payload);
    }
    else {
      Serial.println("GET Request failed");
      Serial.println(httpCode);
    }//end httpCode
    
  }//END https.begin

  else {
    Serial.println("HTTPS connection failed");
  }

  delay(3000);
}//END LOOP
