LArkema/dctransistor-project/(commit log)

2021-10-22 Initial arduino code
2022-01-11 Update compile-sketches.yml
    try esp8266 board with fqbn
2022-01-11 Replace secret file name in action
    [test_code.ino]
2022-01-12 Create lint-sketches.yml
    Add action to run Arduino Lint on code.
2022-01-12 Add shell command to get api cert fingerprint
2022-01-12 Small code fixes after linting
    [simple_move.ino, test_code.ino]
2022-01-22 Create requirements.txt
    Try adding Arduino library to requirements.txt
2022-01-22 Update requirements.txt
    Add ArduinoJson library dependency
2022-01-22 Create bom.json
    Initial SBOM for direct and cryptography (i.e. high-risk) libraries.
2022-01-23 Bill of Materials reference schema and syntax fix
2022-01-23 Create bom-validator.yml
    Test Github actions BOM validation
2022-01-23 Update bom-validator.yml
    fix path to yajsv
2022-01-25 test_code updates LEDs based on real WMATA data. Download and configure station IDs to Circuit IDs
2022-02-11 Commit functional, StationPredictions based PoC. (Doesn't handle edge cases, will update)
    [SimpleList.h, test_code.ino]
2022-02-15 Flawfinder ignore printf
2022-02-16 Add way to set the current state at boot-up in SimpleList. Needs error / bound checking and unit tests.
    [SimpleList.h, test_code.ino]
2022-02-20 Add error checking to InitialStations and begin last staion handling
    [SimpleList.h, test_code.ino]
2022-02-22 Migrate LED setting to TrainLine. Begin work on last train.
2022-03-01 Isolate and add tests for last train arrival. Fix bug!
    [LastTrainTest.ino, SimpleList.h, SimpleListTest.ino, TrainLine.h, miscFuncs.h, test_code.ino]
2022-03-12 Update BOM with dependency updates after compilation
2022-03-12 Consolidate BOM update, validate, and push steps
2022-03-12 Fix false negative in git commit logic, remove separate BOM validator action (now part of compile)
2022-03-12 Update Dependency Versions in BOM
2022-03-12 Separate BOM update, validate, and push to separate steps
2022-03-14 Make Direction 1 (negative) work by itself and Fix GitHub Action bug (only push BOM)
    [TrainLine.h, miscFuncs.h, test_code.ino]
2022-03-15 Fix BOM push logic (always are modified files, not always bom)
2022-03-29 Separate LED update function (set LEDs based on bi-directional state, not setting on arrival)
2022-03-30 Bi-directional, simulataneous tracking and LEDs
2022-03-31 Mostly-stateless LED updating
2022-04-03 Add LED library to compile action
2022-04-03 Update BOM and BOM_update with LED Backpack library
2022-05-15 Move from LED matrix to strip, add multiple simulaneous lines.
2022-06-30 Update README.md
    Remove AUnit button (no longer relevant
2023-01-11 Create arduino_secrets.h
    remove "example_" from file name
2023-01-11 Edit compile and BOM update action
2023-01-11 remove arduino_secrets from test_code
2023-01-11 Add WiFi info filter
2023-01-11 Only get first output of board version number in bom_update
2023-01-22 Create Update SSL fingerprints
    Add action to auto-update SSL fingerprints
2023-01-22 Test ability to auto-correct ssl fingerprints
    [auto_update.h]
2023-01-23 Migrate library and BOM update to separate action
2023-01-23 Move library and BOM update to separate action
2023-01-23 Test BOM update and remove LED Backpack lib
2023-01-23 Update arudino-cli board install in action
2023-01-23 Fix update fingerprints
2023-01-23 Really bix board install command
2023-01-23 Try testing without installing board
2023-01-23 Update BOM
2023-01-23 Fix check for auto-update
    [config.h]
2023-01-25 Update SSL fingerprint
2023-01-30 Update SSL fingerprint compile logic
2023-02-07 Update update-fingerprints.yml
    Update output to trigger compile action
2023-03-08 Add Setup code and blue update LED
2023-03-08 Add show to blue update LED
2023-03-11 Fix HTTP error LED display
    [DCTransistor.ino, Setup.ino, config.h]
2023-03-11 Disable print
2023-04-08 Add board files
    Upload files needed to create a DCTransistor PCB board
    [DCTransistor.kicad_sch, DCTransistor_BOM.xlsx]
2023-08-16 Fix API info deserialization memory bug
    [DCTransistor.ino, config.h]
2023-09-24 Fix leftover use of led_to_station_map
    [TrainLine.h]
2023-09-24 Move setup-arduino-cli to 1.1.2
2023-12-02 Fix extra quote in build
    [config.h]
2023-12-02 Fix bidirectional autoupdate value
    [config.h]
2023-12-02 Replace single API key with multiple to choose from
    [DCTransistor-Bidirectional.ino, DCTransistor.ino, config.h]
2023-12-12 Fix Stand board Orange LED color
    [config.h]
2023-12-12 Use right version number for orange LED fix
    [config.h]
2024-02-04 Update config.h with amber LED hex
    Change OR_HEX_COLOR from FF8000 to FF00FF to reflect a more "amber" color (closer to orange).
2024-02-18 Change color for both boards and use proper color change
2024-02-18 Fix setup arduino versions, create new release, and lower refresh rate
    [config.h]
2024-03-23 Add special train feature to track cherry blossom and other wrapped trains
2024-03-24 Fix crash on no special train
    [DCTransistor-Bidirectional.ino, DCTransistor.ino, config.h]
2024-03-24 Remove special_train_dir refs from standard board
2024-07-03 Update standard board config.h w/ new version num
2024-07-28 Version 2.0.0: Update data source, parsing, and refresh rate
    [ordered_station_geometries.csv, red_line_geometry_tracker.csv, station_geometries.csv, train_geometry_tracker.csv, train_trkid_tracker.csv]
2024-07-30 Fix Macro Names so fingerprint updates still work. Push arduino-cli action to latest version.
    [DCTransistor-Bidirectional.ino, config.h]
2024-07-31 Fix update-fingerprints (real)
2024-08-04 Really actually fix update-fingerprints
    [config.h]
2024-08-19 Properly fix update-fingerprints action
    [config.h]
2024-09-09 Re-add red line stations from summer closure. Add Bidirectional board Kicad and SVG physical files
    [DCTransistor_Bidirectional.kicad_sch, DCTransistor_Bidirectional_BOM.xlsx, DCTransistor_standard.kicad_sch, DCTransistor_standard_BOM.xlsx]
2025-04-06 Bug Fix: Parse special train "null" Tti values
    Attempting to directly convert string from WMATA API to int without checking if string was null caused board to crash.
    [auto_update.h, config.h]
2025-05-26 Fix continuous update from WiFi manager bom
